frogfigther/Reach/README.md

# Reach
A repository containing the design files for the Reach board

Credit goes to Elias bakken for designing the basis of the reach, which we are now finishing 

(URL: http://bit.ly/2AH00zA)
