frogfigther/Reach/Reach_BOM_rev_B0.xls

Digikey Part nr. | Desc | Ref | QTY 1 | P. ea 1 | P. ext 1 | QTY 500 | P. ea 500 | P. ext 500
Connectors
A19450-ND | CONN HEADER RTANG 2POS .100 TIN | X4, X5, X6 | 3 | 0.1 | 0.3 | 1500 | 0.03768 | 56.52
A19451-ND | CONN HEADER RTANG 3POS .100 TIN | X7, X8, X9 | 3 | 0.14 | 0.42 | 1500 | 0.05733 | 85.995
A19452-ND | CONN HEADER RTANG 4POS .100 TIN | X14, X15, X16 | 3 | 0.18 | 0.54 | 1500 | 0.08734 | 131.01
WM7847-ND | CONN HEADER 4POS 5.08MM R/A TIN | X2 | 1 | 1.04 | 1.04 | 500 | 0.648 | 324
WM7953-ND | CONN TERM BLOCK 4POS 5.08MM R/A | X2-2, X20-2 | 1 | 2.5 | 2.5 | 500 | 1.5 | 750
WM7845-ND | CONN HEADER 2POS 5.08MM R/A TIN | X1, X3, X21 | 3 | 0.64 | 1.92 | 1500 | 0.4 | 600
WM7819-ND | CONN TERM BLOCK 2POS 5.08MM | X1-2, X3-2, X21-2 | 3 | 1.43 | 4.29 | 1500 | 0.88794 | 1331.91
S2012EC-23-ND | CONN HEADER .100" DUAL STR 46POS | P8, P9 | 2 | 0.72 | 1.44 | 1000 | 0.41646 | 416.46
ICs
296-28915-5-ND | IC CTRLR STEPPER MOTOR 28HTSSOP | U13, U14, U15 | 3 | 6.53 | 19.59 | 1500 | 3.2625 | 4893.75
CAT24C256WI-GT3OSCT-ND | IC EEPROM 256KBIT 400KHZ 8SOIC | U18 | 1 | 0.71 | 0.71 | 500 | 0.35536 | 177.68
MCP1402T-E/OTCT-ND | IC MOSFET DRIVER 500MA SOT23-5 | U7, U8, U9 | 3 | 0.74 | 2.22 | 1500 | 0.47 | 705
296-4620-1-ND | IC 8BIT SHFT REG TRI-ST 16-TSSOP | U1, U2, U3 | 3 | 0.49 | 1.47 | 1500 | 0.1326 | 198.9
1028-1045-1-ND | IC REG BUCK ADJ 2A 10MSOP | U10 | 1 | 0.76 | 0.76 | 500 | 0.38192 | 190.96
Resistors
RL12S.10FCT-ND | RES .10 OHM 1/3W 1% 0805 SMD | R1, R2, R3, R4, R5, R6 | 6 | 0.32 | 1.92 | 3000 | 0.06306 | 189.18
P100JCT-ND | RES 100 OHM 1/10W 5% 0402 SMD | R31, R32, R37 | 3 | 0.1 | 0.3 | 1500 | 0.0072 | 10.8
311-4.7KJRCT-ND | RES 4.7K OHM 1/16W 5% 0402 SMD | R7, R8, R9, R11, R12, R14, R15, R16, R19, R20, R21, R22, R23, R24, R35, R36, R45, R46, R47, R48, R55, R56, R57 | 23 | 0.012 | 0.276 | 11500 | 0.00336 | 38.64
P4.70KLCT-ND | RES 4.7K OHM 1/10W 1% 0402 SMD | R13, R17, R18 | 3 | 0.1 | 0.3 | 1500 | 0.01008 | 15.12
P6.8KJCT-ND | RES 6.8K OHM 1/10W 5% 0402 SMD | R38, R39, R40 | 3 | 0.1 | 0.3 | 1500 | 0.0072 | 10.8
P10KJCT-ND | RES 10K OHM 1/10W 5% 0402 SMD | R43 | 1 | 0.1 | 0.1 | 500 | 0.0072 | 3.6
RMCF0402FT40K2CT-ND | RES 40.2K OHM 1/16W 1% 0402 | R44 | 1 | 0.04 | 0.04 | 500 | 0.00576 | 2.88
RMCF0402FT120KCT-ND | RES 120K OHM 1/16W 1% 0402 | R42 | 1 | 0.04 | 0.04 | 500 | 0.00576 | 2.88
MOSFETs
AUIPS1051L-ND | IC SW IPS 1CH LOW SIDE SOT223 | Q4, Q5, Q6 | 3 | 1.28 | 3.84 | 1500 | 0.51294 | 769.41
785-1370-1-ND | MOSFET N-CH 30V 32A 8DFN | Q1, Q2, Q3 | 3 | 0.8 | 2.4 | 1500 | 0.4004 | 600.6
Capacitors
445-1256-1-ND | CAP CER 1000PF 50V 10% X7R 0402 | C56 | 1 | 0.1 | 0.1 | 500 | 0.0077 | 3.85
587-2237-1-ND | CAP CER 4700PF 50V 10% X7R 0402 | C57, C58, C59 | 3 | 0.08 | 0.24 | 1500 | 0.0096 | 14.4
311-1360-1-ND | CAP CER 10000PF 25V 10% X7R 0603 | C1, C3, C5, C54, C55 | 5 | 0.1 | 0.5 | 2500 | 0.00648 | 16.2
445-4964-1-ND | CAP CER 0.1UF 25V 10% X5R 0402 | C2, C4, C6, C13, C20, C22, C24, C27, C31, C33, C35, C38, C39, C40, C41, C42 | 16 | 0.04 | 0.64 | 8000 | 0.0102 | 81.6
445-4996-1-ND | CAP CER 0.47UF 6.3V 10% X5R 0402 | C14, C15, C16, C26, C45, C46 | 6 | 0.1 | 0.6 | 3000 | 0.0231 | 69.3
1276-1903-1-ND | CAP CER 4.7UF 25V 20% X5R 0603 | C30, C32, C34 | 3 | 0.3 | 0.9 | 1500 | 0.08188 | 122.82
445-11700-1-ND | CAP CER 10UF 25V 20% JB 1206 | C52 | 1 | 0.56 | 0.56 | 500 | 0.196 | 98
1276-2412-1-ND | CAP CER 22UF 6.3V 20% X5R 0805 | C53 | 1 | 0.27 | 0.27 | 500 | 0.066 | 33
PCE3917CT-ND | CAP ALUM 100UF 50V 20% SMD | C12 | 1 | 0.81 | 0.81 | 500 | 0.33496 | 167.48
Diodes/LEDs
475-2816-1-ND | LED CHIPLED BLUE 470NM 0603 SMD | LED1, LED2, LED3, LED4, LED5, LED6, LED7 | 7 | 0.21 | 1.47 | 3500 | 0.11178 | 391.23
475-3016-1-ND | LED POINTLED 628NM SUPER RED SMD | LED8, LED9, LED10, LED11 | 4 | 0.08 | 0.32
MBRA340T3GOSCT-ND | DIODE SCHOTTKY 40V 3A SMA | D1, D2, D3, D4 | 4 | 0.53 | 2.12 | 2000 | 0.24812 | 496.24
Inductors
587-2636-1-ND | INDUCTOR 33UH 1.7A 20% SMD | L2 | 1 | 0.57 | 0.57 | 500 | 0.37126 | 185.63
Other
F4991-ND | FUSE BLADE LP MINI 58V SILVR 20 | F1 | 1 | 0.96 | 0.96 | 500 | 0.495 | 247.5
3557K-ND | FUSE CLIP UNIVERSL AUTO BLADE PC | F1-1 | 2 | 0.21 | 0.42 | 1000 | 0.1148 | 114.8
CT2192MST-ND | SWITCH TAPE SEAL 2 POS SMD | S1 | 1 | 0.6 | 0.6 | 500 | 0.43302 | 216.51
Sum |  |  |  |  | 57.796 |  |  | 27.52931
