frogfigther/Reach/B0/Reach_B0_BOM v0.1.xlsx

Sheet: Reach_B0_BOM v0.1
Qty | Value | Description | Digikey | Qty 1 | Qty 10 | Qty 100 | Qty 500 | Qty 1000/5000 | Board Qty 1 |  | Board Qty 100 |  | Board Qty 500
6 | 22-05-7028-02 | CONNECTOR | A19450-ND | $0.10 | $0.81 | $5.01 | $20.73 | $82.04 | $0.60 |  | $24.88 |  | $15.03
3 | 22-05-7048-04 | CONNECTOR | A19452-ND | $0.16 | $1.54 | $9.50 | $39.30 | $68.78 | $0.48 |  | $28.50 |  | $14.25
9 | 74AHC1G126DCK | Single Bus Buffer Gate With 3-State Outputs | 296-8747-1-ND | $0.42 | $3.14 | $19.57 | $66.95 | $103.00 | $3.14 | Qty 10 | $120.51 |  | $88.06
2 | AON6752 |  | 785-1498-1-ND | $1.13 | $9.97 | $78.83 | $305.68 | $482.66 | $2.26 |  | $157.66 |  | $78.83
8 | BLM15HB121SN1 | EMIFIL (R) Chip Ferrite Bead for GHz Noise | 490-4000-1-ND | $0.19 | $1.45 | $9.33 | $35.25 | $60.13 | $1.45 | Qty 10 | $56.40 |  | $240.52
3 | 100uF |  | PCE4238CT-ND | $0.52 | $3.59 | $21.52 |  |  | $1.56 |  | $64.56 |  | $213.31 | PCE4238TR-ND Tape and Reel
34 | 0.1uF | CAPACITOR, European symbol | 445-12185-1-ND | $0.15 | $1.05 | $4.95 | $17.36 | $122.39 | $3.57 | Qty 10 Break | $118.05 |  | $416.13
2 | 10nF | CAPACITOR, European symbol | 445-12173-1-ND | $0.10 | $0.36 | $1.61 | $5.76 | $9.04 | $0.20 |  | $3.22 |  | $9.04
1 | 1nF | CAPACITOR, European symbol | 490-6315-1-ND | $0.10 | $0.26 | $1.18 | $4.22 |  | $0.10 |  | $1.18 |  | $4.22
3 | 22nF | CAPACITOR, European symbol | 490-8256-1-ND | $0.10 | $0.26 | $1.18 | $4.22 |  | $0.26 | Qty 10 | $3.54 |  | $12.66
14 | 4.7uF | CAPACITOR, European symbol | 490-5915-1-ND | $0.49 | $3.41 | $20.46 | $76.71 | $129.25 | $4.77 | Qty 10 Break | $214.79 |  | $180.95
6 | 10uF | CAPACITOR, European symbol | 587-3489-1-ND | $0.31 | $2.12 | $12.00 | $42.36 |  | $1.86 |  | $50.83 |  | $254.16
1 | CAT24C256 |  | CAT24C256WI-GT3OSCT-ND | $0.40 | $3.89 | $31.93 | $155.21 |  | $0.40 |  | $31.93 |  | $155.21
2 | F-2X23- |  | SAM1204-23-ND | $4.95 | $44.28 | $364.68 | $1441.36 | $2474.63 | $9.90 |  | $729.36 |  | $2474.63
1 | FUSE | Fuse | F4991-ND | $0.37 | $3.47 | $24.20 | $93.50 |  | $0.37 |  | $24.20 |  | $93.50
2 | FUSE | Fuse | 36-3557-ND | $0.21 | $1.97 | $13.68 | $57.86 | $94.68 | $0.42 |  | $27.36 |  | $94.68
8 | blue | LED | 475-2816-1-ND | $0.34 | $2.40 | $15.97 | $47.92 | $79.86 | $2.40 | Qty 10 | $76.67 |  | $319.44
1 |  | Header 2 | 277-1667-ND | $0.39 | $3.75 | $34.92 | $150.14 |  | $0.39 |  | $34.92 |  | $150.14
4 | MBRA340T3 | Surface Mount Schottky Power Rectifier | MBRA340T3GOSCT-ND | $0.47 | $4.02 | $29.98 | $117.78 | $182.03 | $1.88 |  | $117.78 | Qty 500 | $364.06
4 | MCP9600 |  | MCP9600-I/MX-ND | $5.04 |  | $382.13 |  |  | $20.16 |  | $1528.52 |  | $7642.60
2 | MSTBA2 | PHOENIX | 277-1106-ND | $0.60 | $5.75 | $53.48 | $229.91 | $416.50 | $1.20 |  | $106.96 |  | $416.50
1 | MSTBA4 | PHOENIX | 277-7452-ND | $1.30 | $12.63 | $108.56 | $477.90 |  | $1.30 |  | $108.56 |  | $477.90
3 | NEWPORT_THERMOCOUPLE_CONNECTORPCC-SMP-V | Newport Electronics miniature Thermocouple connector. | PCC-SMP-V-K | $2.20 |  |  |  | Newark Only | $6.60 |  | $660.00 |  | $3300.00
4 |  | NPN TRANSISTOR | MMBT2222ALT1GOSCT-ND | $0.11 | $1.01 | $5.52 | $16.99 | $23.17 | $0.44 |  | $16.99 | Qty 500 | $46.34
1 | PCA9685PW | 16-channel, 12-bit PWM Fm+ I2C-bus LED controller | 568-5931-1-ND | $2.43 | $21.84 | $175.51 | $721.00 |  | $2.43 |  | $175.51 |  | $721.00
13 | 10K | RESISTOR, European symbol | RMCF0402FT10K0CT-ND | $0.10 | $0.20 | $0.81 | $3.64 | $13.06 | $1.30 |  | $9.46 |  | $16.98
1 | 120K,1% | RESISTOR, European symbol | RMCF0402FT120KCT-ND | $0.10 | $0.20 | $0.81 | $3.64 |  | $0.10 |  | $0.81 |  | $3.64
3 | 2.2R | RESISTOR, European symbol | RMCF0402FT2R20CT-ND | $0.10 | $0.21 | $0.86 |  | $3.85 | $0.30 |  | $2.58 |  | $5.78
1 | 39K | RESISTOR, European symbol | RMCF0402FT39K0CT-ND | $0.10 | $0.20 | $0.81 |  | $3.64 | $0.10 |  | $0.81 |  | $3.64 | Qty 1000
2 | 4.3k | RESISTOR, European symbol | RMCF0402FT4K30CT-ND | $0.10 | $0.20 | $0.81 |  | $3.64 | $0.20 |  | $1.62 |  | $3.64
22 | 4.7K | RESISTOR, European symbol | RMCF0402FT4K70CT-ND | $0.10 | $0.20 | $0.81 |  | $13.06 | $0.44 | Qty 10 Break | $57.46 |  | $28.73
2 | 7.5k | RESISTOR, European symbol | RMCF0402FT7K50CT-ND | $0.10 | $0.20 | $0.81 |  | $3.64 | $0.20 | Qty 10 | $1.62 |  | $3.64
6 | 0.1R | RESISTOR, European symbol | RMCF0805JTR100CT-ND | $0.44 | $3.18 | $12.73 |  | $145.31 | $2.64 |  | $76.38 |  | $174.37
1 | 0 | Resistor | 311-0.0JRCT-ND | $0.10 | $0.10 | $0.38 | $1.15 |  | $0.10 |  | $0.38 |  | $1.15
8 | 100 | Resistor | RMCF0402FT100RCT-ND | $0.10 | $0.20 | $0.81 | $3.64 | $7.91 | $0.20 | Qty 10 | $3.64 | Qty 500 | $13.05 | Qty 5000
1 | 2.2k | Resistor | RMCF0402FT2K20CT-ND | $0.10 | $0.20 | $0.81 | $3.64 |  | $0.10 |  | $0.81 |  | $3.64
6 | 0 | Resistor | RMCF0805ZT0R00CT-ND | $0.10 | $0.16 | $0.65 | $1.98 | $2.92 | $0.16 | Qty 10 | $2.38 |  | $8.76
20 | 10k | Resistor | RMCF0805FT10K0CT-ND | $0.10 | $0.23 | $0.95 |  |  | $0.46 | Qty 10 Break | $19.00 |  | $26.50 | RMCF0805FT10K0TR-ND
1 | 33uH |  | 587-2636-1-ND | $0.62 | $5.43 | $38.81 | $163.01 |  | $0.62 |  | $38.81 |  | $163.01
1 | RT8268 |  | 1028-1045-1-ND | $0.74 | $6.49 | $50.06 | $185.40 |  | $0.74 |  | $50.06 |  | $185.40
3 | SN74AHC595PW | 8 bit shift registers with 3-state output registers | 296-4620-1-ND | $0.54 | $4.64 | $34.61 | $135.96 | $210.12 | $1.62 |  | $103.83 |  | $315.18
3 | TMC2130QFN36 |  | 1460-1130-1-ND | $5.33 | $47.58 | $390.16 | $1579.66 |  | $15.99 |  | $1170.48 |  | $4738.98
 |  |  |  |  |  |  |  | Totals | $93.41 |  | $6023.01 |  | $23479.25
 |  |  |  |  |  |  |  | Cost Per Board | $93.41 |  | $60.23 |  | $46.96

Sheet: Issues
C10, C12, C15, C19, C21, C31, C34, C37, C40, C77, C57, C59, C45, C46
Not available in an 0402 format. Smallest I can find is an 0603 format with ratings to match the other caps
