frogfigther/Reach/B0/i2c_addresses.xls

I2C address/capacitance table
For keeping track of used addresses and pullup resistor calculation
Replicape
Ref Des | IC | Address | Capacitance (pF)
U11 | PCA9685PW | 1111111X | 10
U18 | CAT24C256 | 1010100X | 8
Reach
U11 | PCA9685PW | 1011111X | 10
U18 | CAT24C256 | 1010101X | 8
U3 | MCP9600 | 1100000X | 5
U4 | MCP9600 | 1100001X | 5
U5 | MCP9600 | 1100010X | 5
U6 | MCP9600 | 1100011X | 5
 |  | Total: | 56
