frogfigther/Reach/B0/schematic.pdf

2 | 4 ³ ⁵ | + +- | - ABCDE | 1 | 2 | 3 | 4 | 5 | 6 | 7 | 8 | ABCDE 1 | 2 | 3 | 4 | 5 | 6 | 7 | 8

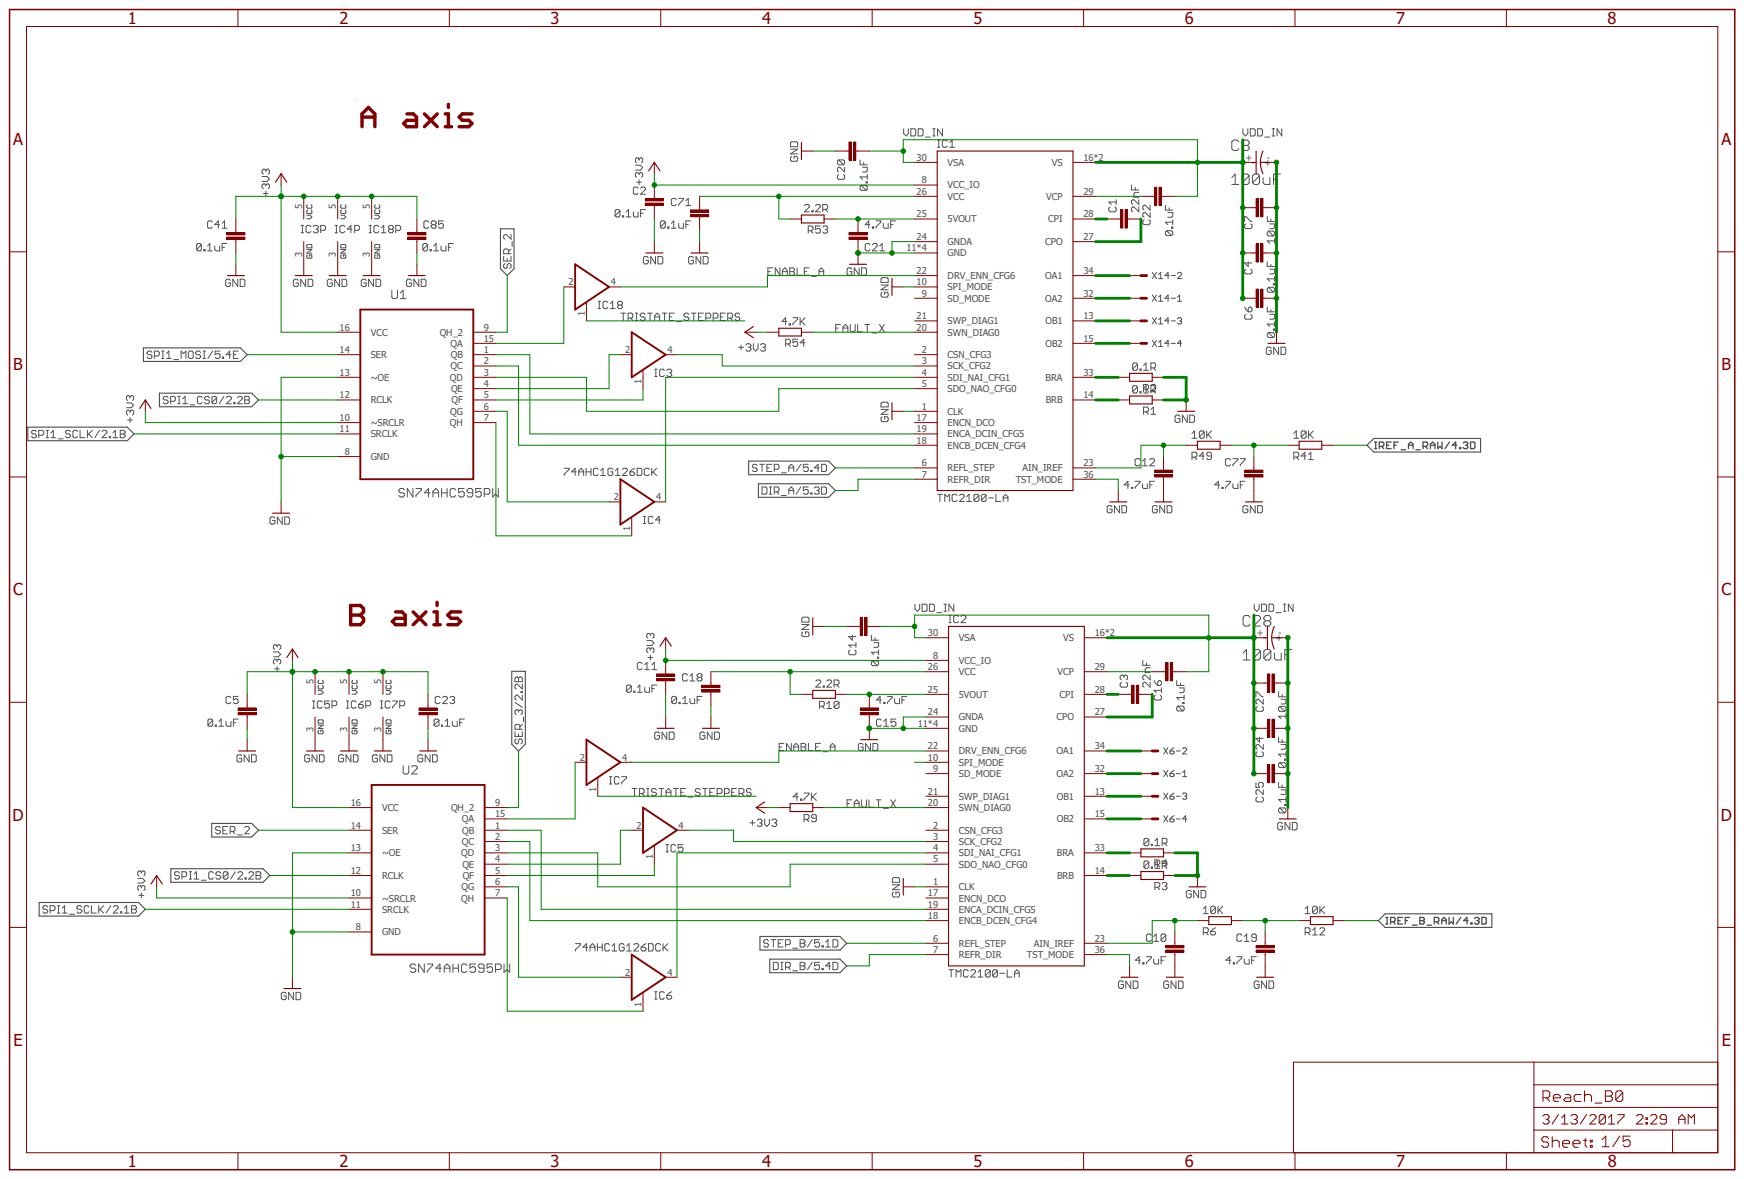
[picture p1: page 1]
VCC 16; SER 14; RCLK 12; ~SRCLR 10; SRCLK 11; GND 8; TST_MODE; CLK 1; CSN_CFG3 2; SCK_CFG2 3; SDI_NAI_CFG1 4; GND 11*4; SDO_NAO_CFG0 5; REFL_STEP 6 REFR_DIR 7; VCC_IO 8; SD_MODE 9; SPI_MODE 10; 13 BRB; ENCN_DCO 17; ENCB_DCEN_CFG4 18; ENCA_DCIN_CFG5 19; SWN_DIAG0 20; SWP_DIAG1 21; DRV_ENN_CFG6 22; AIN_IREF; GNDA 24; 5VOUT 25; VCC 26; CPO; CPI; VCP; VSA 30; 32 BRA

A

1 | 2 | 3 | 4 | 5 | 6 | 7 | 8

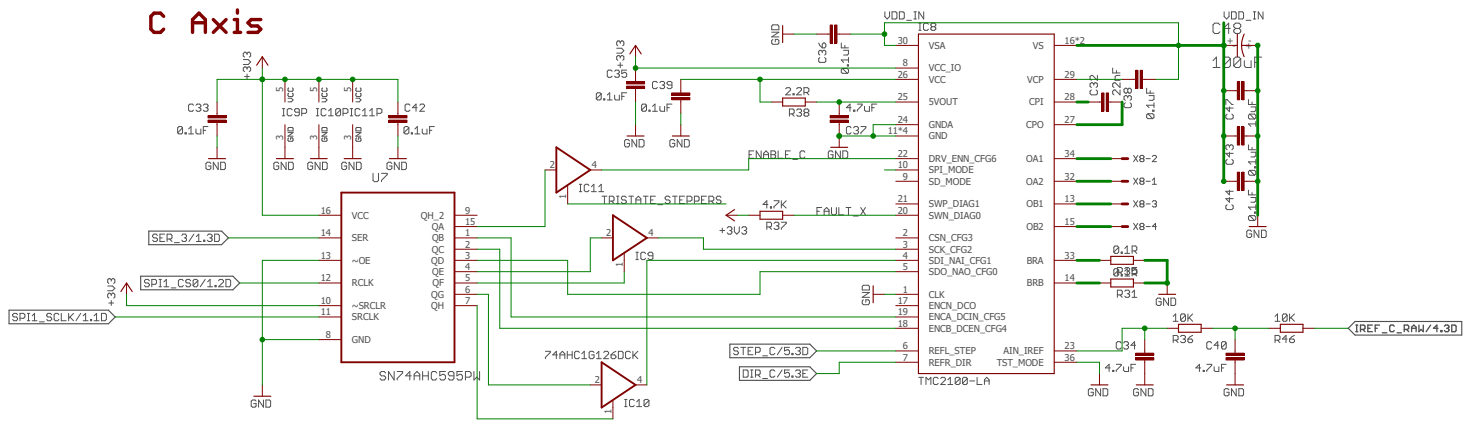
[picture p2: page 2]
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

A

A

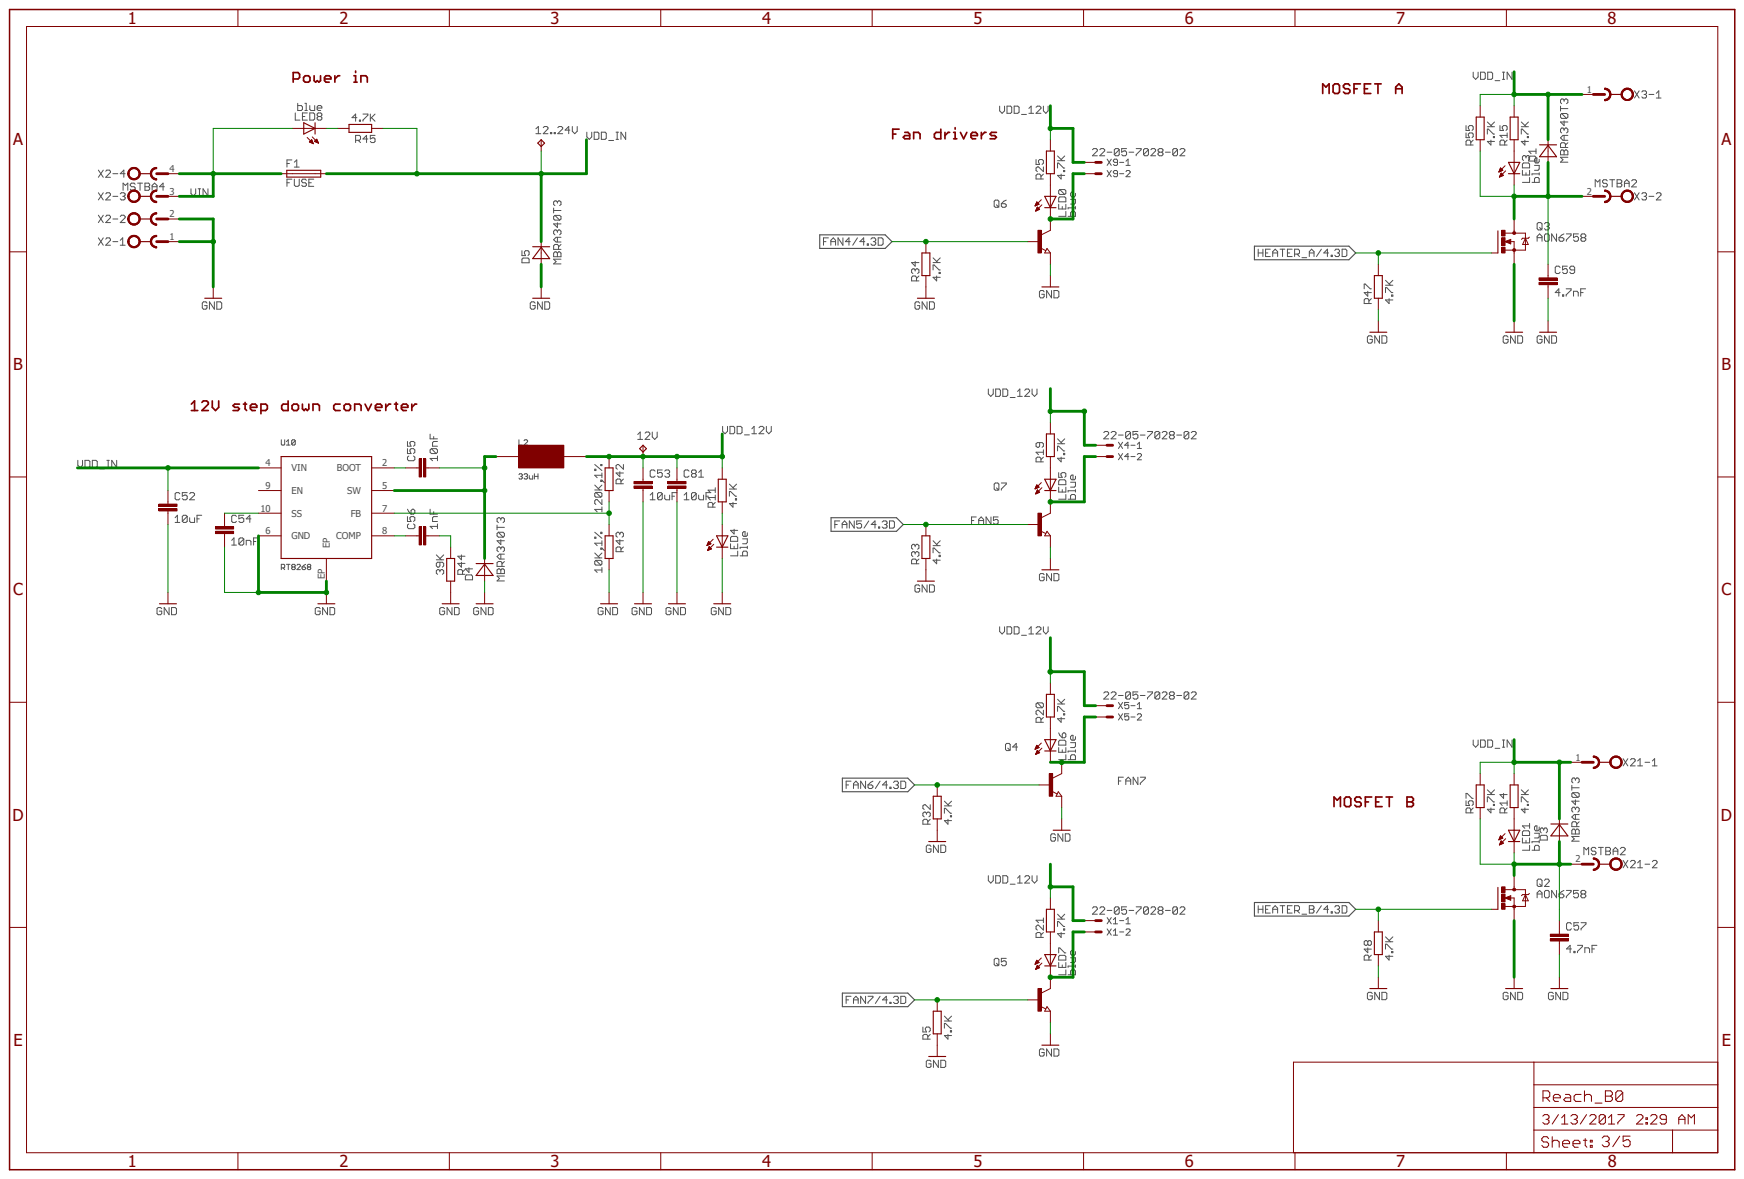
[picture p3: page 3]
BOOT; 7 COMP; 8 VIN 4; GND 6

SDA PAD ABCDE | 1 | 2 | 3 | 4 | 5 | 6 | 7 | 8 | ABCDE 1 | 2 | 3 | 4 | 5 | 6 | 7 | 8

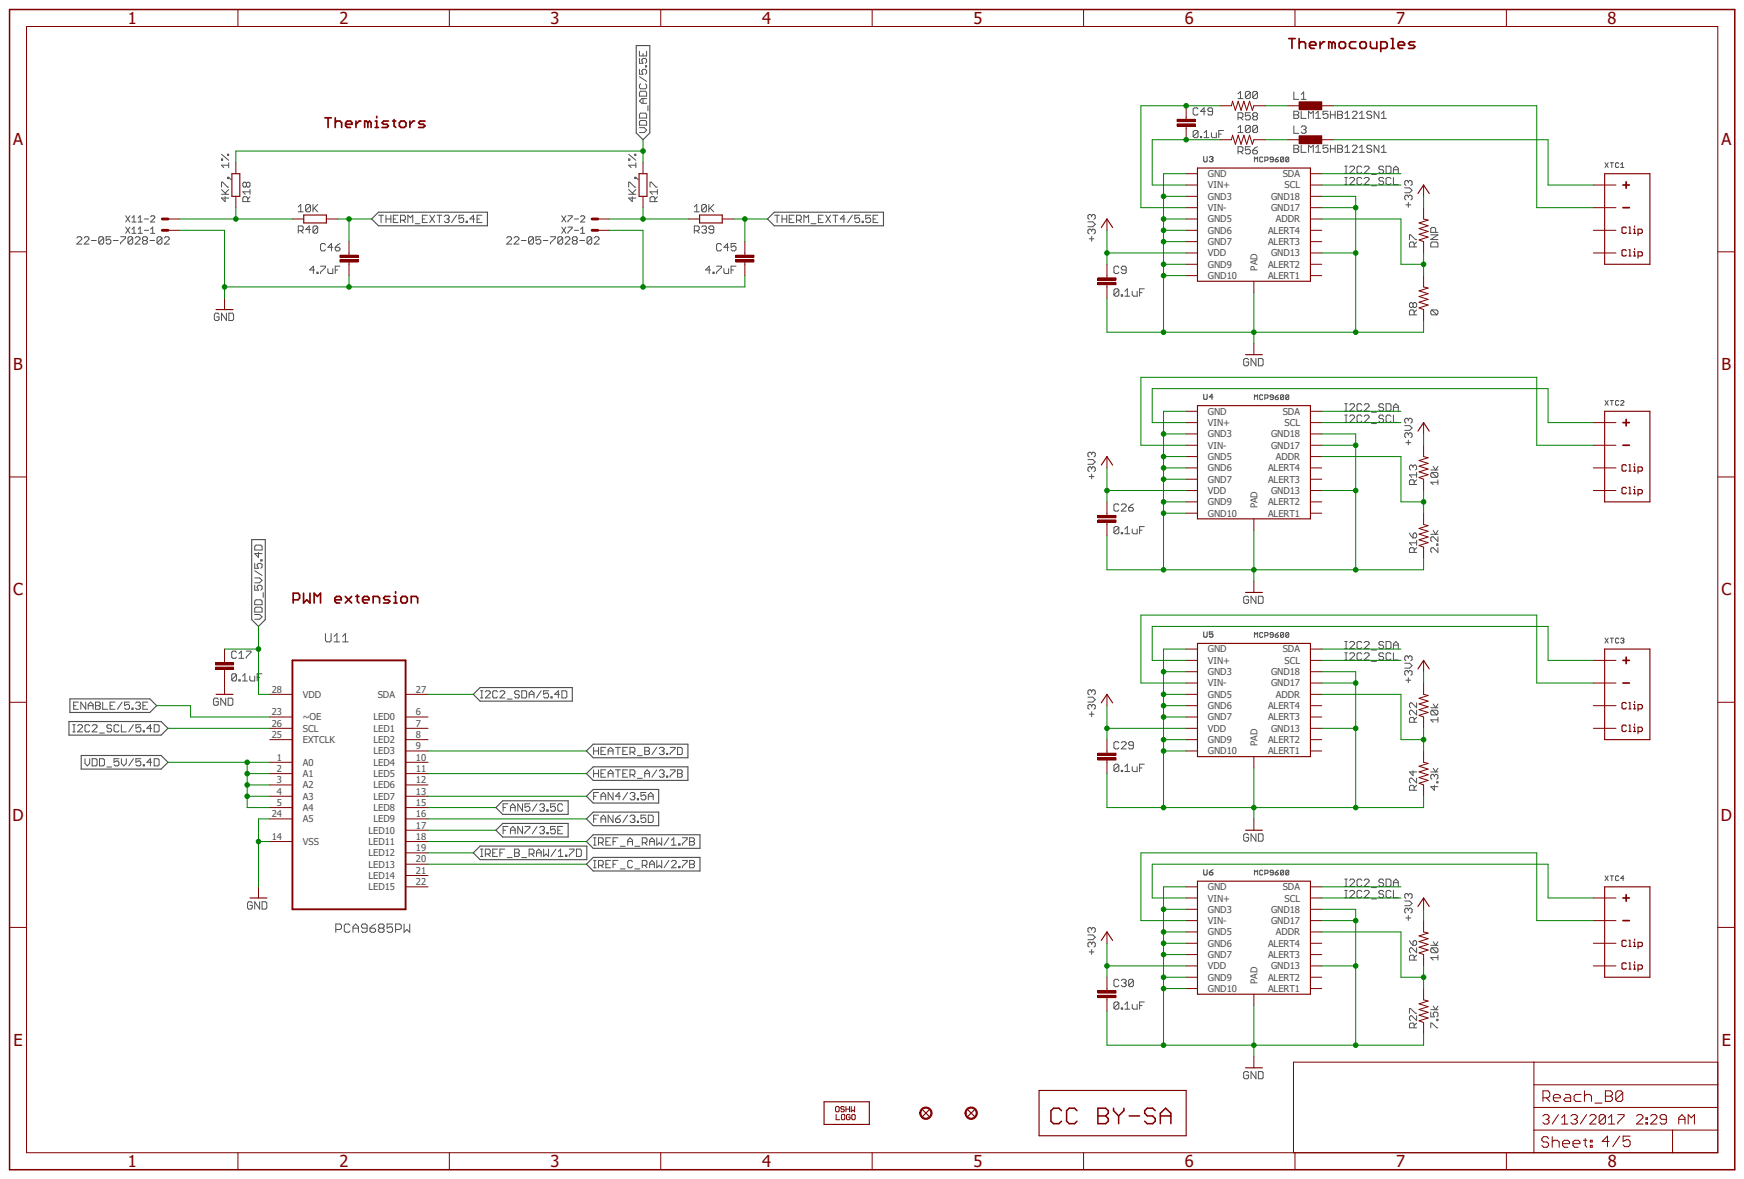
[picture p4: page 4]

45 | 46 ABCDE | 1 | 2 | 3 | 4 | 5 | 6 | 7 | 8 | ABCDE 1 | 2 | 3 | 4 | 5 | 6 | 7 | 8

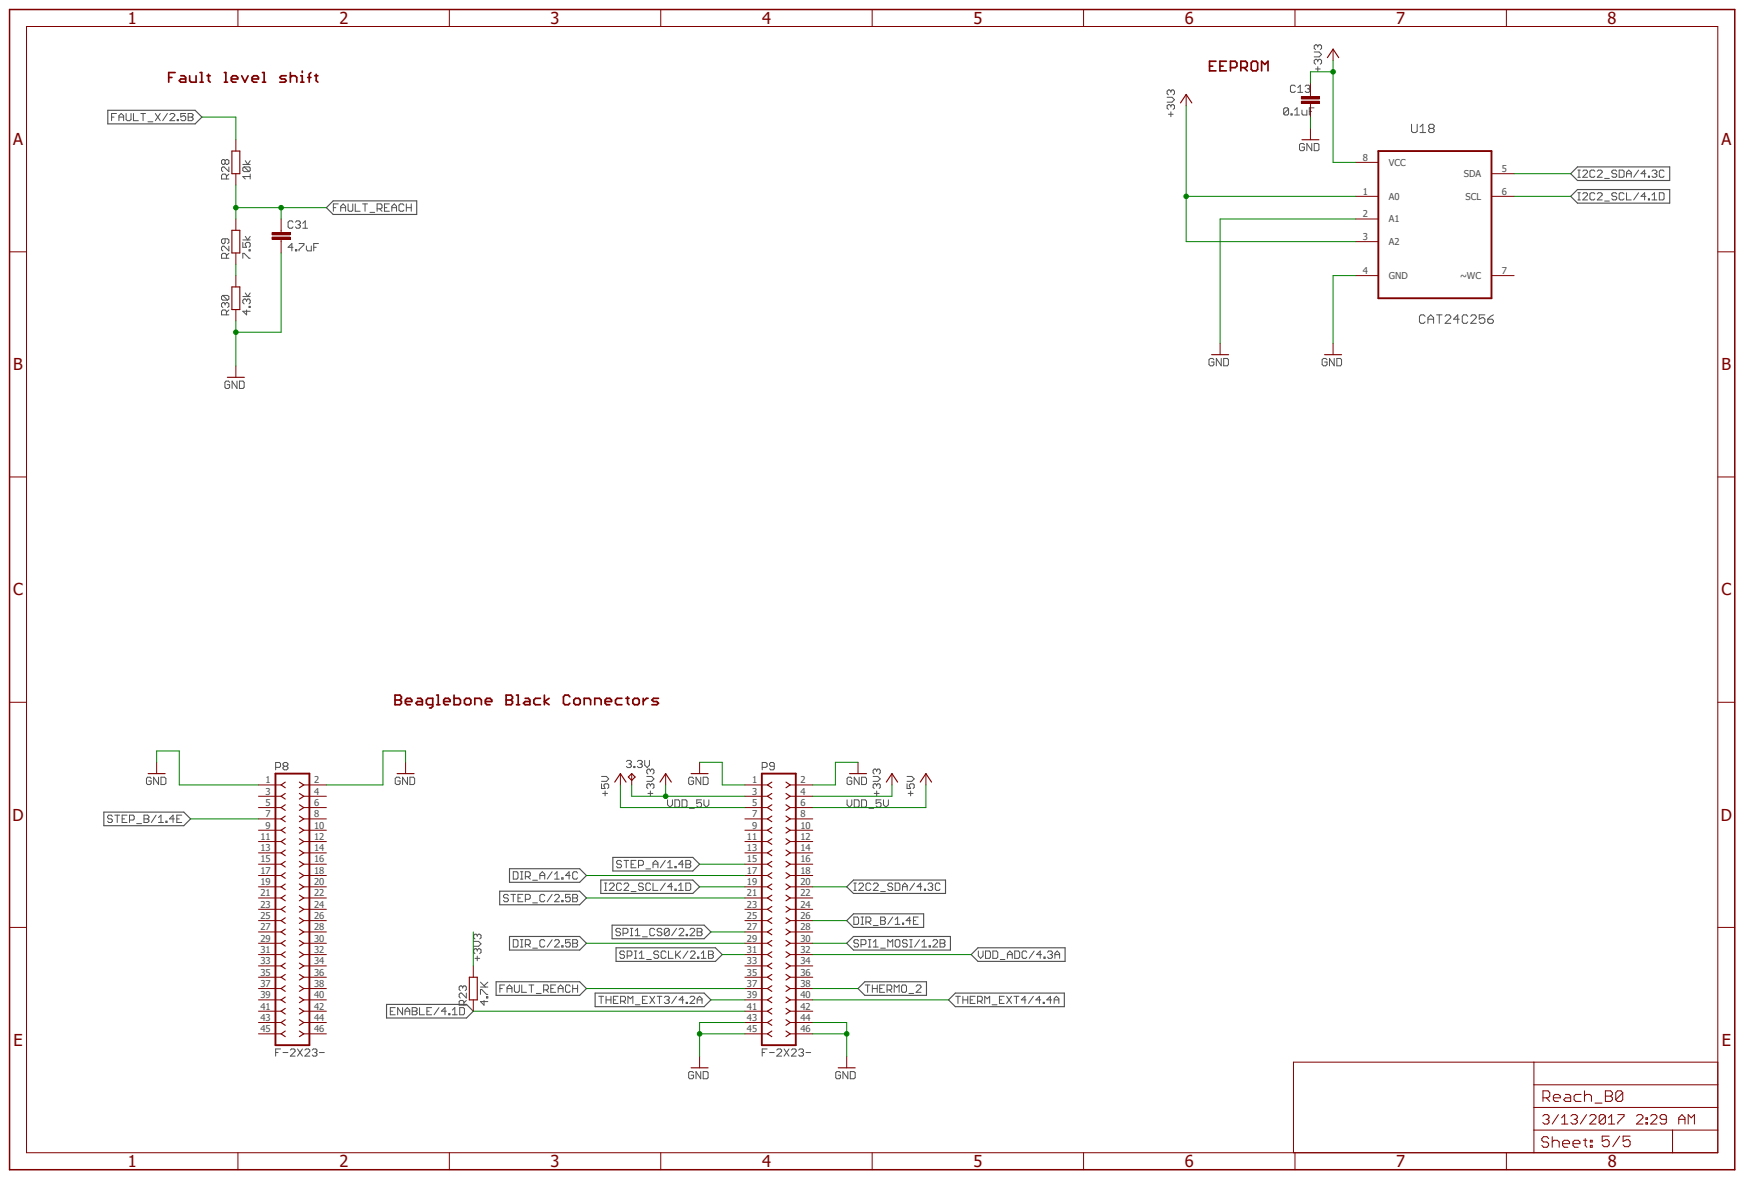
[picture p5: page 5]
VCC 8; 7 SCL; GND 4; SDA
