frogfigther/Reach/B0/Reach_B0.brd

## EAGLE design B0/Reach_B0.brd (2017-11-29)

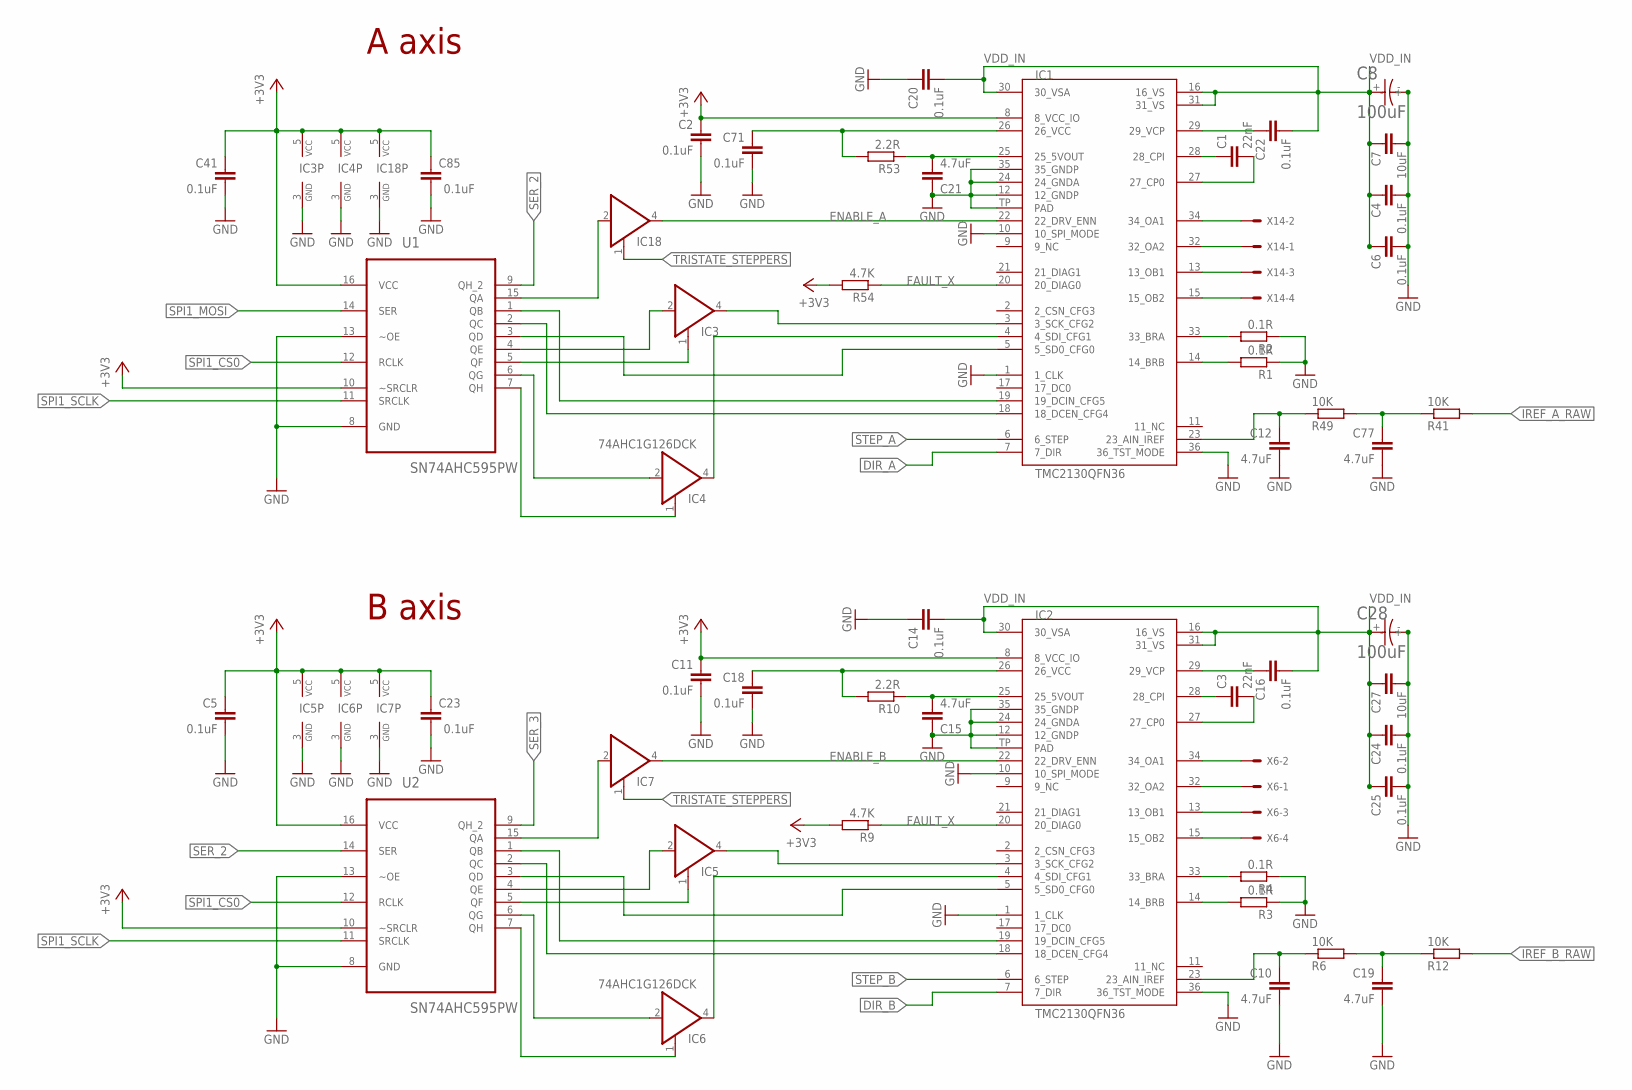
[picture p6: schematic Reach_B0.sch, sheet 1, A&B Stepper drivers]

Parts:
C1, C3: 22nF; C0402
C2, C5, C11, C14, C16, C18, C20, C22, C23, C41, C71, C85: 0.1uF; C0402
C4, C6, C24, C25: 0.1uF; C0402; MPN CL10B104KB8NNND
C7, C27: 10uF; C0805; MPN C2012X5R1V106M085AC
C8, C28: 100uF; RHS1V10MCN1GS; MPN RHS1V101MCN1GS
C10, C12, C15, C19, C21, C77: 4.7uF; C0402
IC1, IC2: TMC2130QFN36; QFN36
IC3, IC4, IC5, IC6, IC7, IC18: 74AHC1G126DCK; SC70-5
R1, R2, R3, R4: 0.1R; R0805
R6, R12, R41, R49: 10K; R0402
R9, R54: 4.7K; R0402
R10, R53: 2.2R; R0402
U1, U2: SN74AHC595PW; SOP65P640X120-16N
X6, X14: 22-05-7048-04; 7395-04

Connections:
+3V3: C2.1, C5.1, C11.1, C23.1, C41.1, C85.1, IC1.8 (8_VCC_IO), IC2.8 (8_VCC_IO), IC3.5 (VCC), IC4.5 (VCC), IC5.5 (VCC), IC6.5 (VCC), IC7.5 (VCC), IC18.5 (VCC), R9.2, R54.2, U1.10 (~SRCLR), U1.16 (VCC), U2.10 (~SRCLR), U2.16 (VCC); also elsewhere on the board
B_A3: IC2.34 (34_OA1), X6.2
B_A4: IC2.32 (32_OA2), X6.1
B_B3: IC2.15 (15_OB2), X6.4
B_B4: IC2.13 (13_OB1), X6.3
DIR_A: IC1.7 (7_DIR); also elsewhere on the board
DIR_B: IC2.7 (7_DIR); also elsewhere on the board
ENABLE_A: IC1.22 (22_DRV_ENN), IC18.4 (O)
ENABLE_B: IC2.22 (22_DRV_ENN), IC7.4 (O)
FAULT_X: IC1.20 (20_DIAG0), IC2.20 (20_DIAG0), R9.1, R54.1; also elsewhere on the board
GND: C2.2, C4.2, C5.2, C6.2, C7.2, C8.-, C10.2, C11.2, C12.2, C14.1, C15.1, C18.2, C19.2, C20.1, C21.1, C23.2, C24.2, C25.2, C27.2, C28.-, C41.2, C71.2, C77.2, C85.2, IC1.1 (1_CLK), IC1.10 (10_SPI_MODE), IC1.12 (12_GNDP), IC1.24 (24_GNDA), IC1.35 (35_GNDP), IC1.36 (36_TST_MODE), IC1.TP (PAD), IC2.1 (1_CLK), IC2.10 (10_SPI_MODE), IC2.12 (12_GNDP), IC2.24 (24_GNDA), IC2.35 (35_GNDP), IC2.36 (36_TST_MODE), IC2.TP (PAD), IC3.3 (GND), IC4.3 (GND), IC5.3 (GND), IC6.3 (GND), IC7.3 (GND), IC18.3 (GND), R1.1, R2.1, R3.1, R4.1, U1.8 (GND), U1.13 (~OE), U2.8 (GND), U2.13 (~OE); also elsewhere on the board
IREF_A: C77.1, R41.1, R49.2
IREF_A_RAW: R41.2; also elsewhere on the board
IREF_B: C19.1, R6.2, R12.1
IREF_B_RAW: R12.2; also elsewhere on the board
unnamed: C3.2, IC2.27 (27_CP0)
unnamed: IC2.14 (14_BRB), R3.2
unnamed: IC2.33 (33_BRA), R4.2
unnamed: IC4.1 (OE), U1.7 (QH)
unnamed: IC4.2 (I), U1.6 (QG)
unnamed: IC1.18 (18_DCEN_CFG4), U1.2 (QC)
unnamed: C1.1, IC1.28 (28_CPI)
unnamed: C1.2, IC1.27 (27_CP0)
unnamed: IC1.14 (14_BRB), R1.2
unnamed: IC1.33 (33_BRA), R2.2
unnamed: C12.1, IC1.23 (23_AIN_IREF), R49.1
unnamed: C10.1, IC2.23 (23_AIN_IREF), R6.1
unnamed: C3.1, IC2.28 (28_CPI)
unnamed: C15.2, IC2.25 (25_5VOUT), R10.1
unnamed: C16.1, IC2.29 (29_VCP)
unnamed: IC2.18 (18_DCEN_CFG4), U2.2 (QC)
unnamed: IC2.19 (19_DCIN_CFG5), U2.1 (QB)
unnamed: IC6.1 (OE), U2.7 (QH)
unnamed: IC6.2 (I), U2.6 (QG)
unnamed: IC5.2 (I), U2.4 (QE)
unnamed: C21.2, IC1.25 (25_5VOUT), R53.1
unnamed: IC5.1 (OE), U2.5 (QF)
unnamed: C22.1, IC1.29 (29_VCP)
unnamed: IC3.2 (I), U1.4 (QE)
unnamed: IC2.5 (5_SD0_CFG0), U2.3 (QD)
unnamed: C18.1, IC2.26 (26_VCC), R10.2
unnamed: IC7.2 (I), U2.15 (QA)
unnamed: IC3.1 (OE), U1.5 (QF)
unnamed: IC1.19 (19_DCIN_CFG5), U1.1 (QB)
unnamed: IC1.5 (5_SD0_CFG0), U1.3 (QD)
unnamed: C71.1, IC1.26 (26_VCC), R53.2
unnamed: IC18.2 (I), U1.15 (QA)
SER_2: U1.9 (QH_2), U2.14 (SER)
SER_3: U2.9 (QH_2); also elsewhere on the board
SPI1_CS0: U1.12 (RCLK), U2.12 (RCLK); also elsewhere on the board
SPI1_MOSI: U1.14 (SER); also elsewhere on the board
SPI1_SCLK: U1.11 (SRCLK), U2.11 (SRCLK); also elsewhere on the board
STEP_A: IC1.6 (6_STEP); also elsewhere on the board
STEP_B: IC2.6 (6_STEP); also elsewhere on the board
TRISTATE_STEPPERS: IC7.1 (OE), IC18.1 (OE); also elsewhere on the board
VDD_IN: C4.1, C6.1, C7.1, C8.+, C14.2, C16.2, C20.2, C22.2, C24.1, C25.1, C27.1, C28.+, IC1.16 (16_VS), IC1.30 (30_VSA), IC1.31 (31_VS), IC2.16 (16_VS), IC2.30 (30_VSA), IC2.31 (31_VS); also elsewhere on the board
X_A1: IC1.34 (34_OA1), X14.2
X_A2: IC1.32 (32_OA2), X14.1
X_B1: IC1.13 (13_OB1), X14.3
X_B2: IC1.15 (15_OB2), X14.4
X_CFG1: IC1.4 (4_SDI_CFG1), IC4.4 (O)
X_CFG2: IC1.3 (3_SCK_CFG2), IC3.4 (O)
X_CFG3: IC2.3 (3_SCK_CFG2), IC5.4 (O)
X_CFG4: IC2.4 (4_SDI_CFG1), IC6.4 (O)

Notes on the sheet:
A axis
B axis

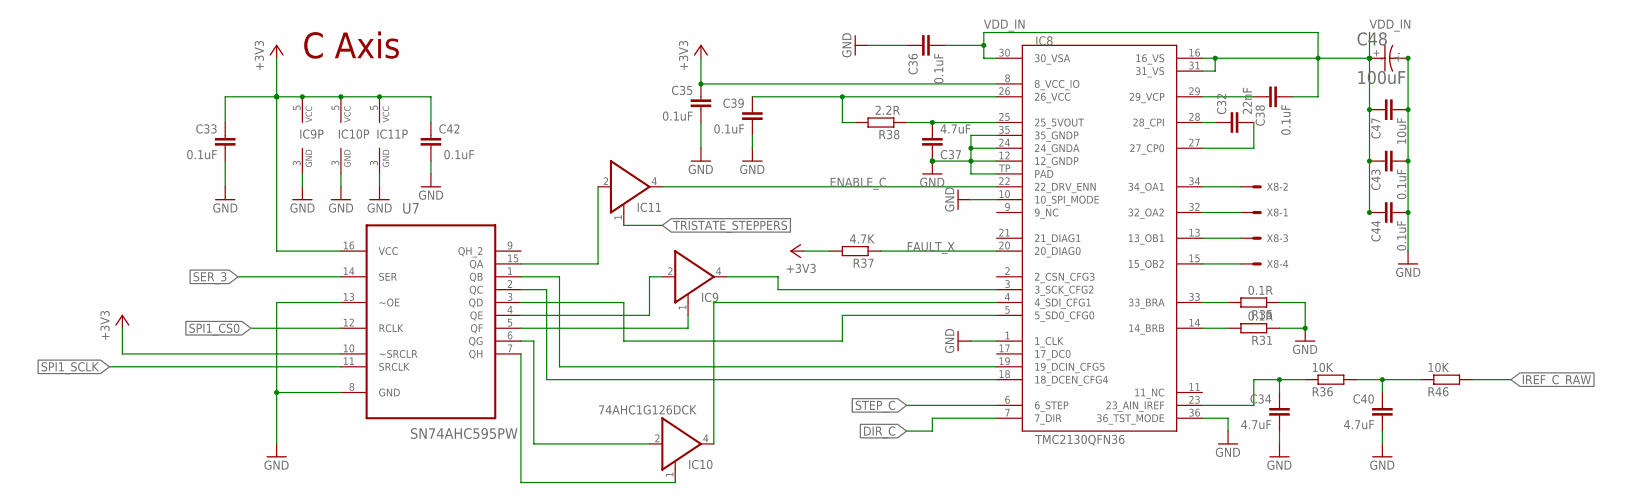
[picture p7: schematic Reach_B0.sch, sheet 2, C Stepper driver]

Parts:
C32: 22nF; C0402
C33, C35, C36, C38, C39, C42: 0.1uF; C0402
C34, C37, C40: 4.7uF; C0402
C43, C44: 0.1uF; C0402; MPN CL10B104KB8NNND
C47: 10uF; C0805; MPN C2012X5R1V106M085AC
C48: 100uF; RHS1V10MCN1GS; MPN RHS1V101MCN1GS
IC8: TMC2130QFN36; QFN36
IC9, IC10, IC11: 74AHC1G126DCK; SC70-5
R31, R35: 0.1R; R0805
R36, R46: 10K; R0402
R37: 4.7K; R0402
R38: 2.2R; R0402
U7: SN74AHC595PW; SOP65P640X120-16N
X8: 22-05-7048-04; 7395-04

Connections:
+3V3: C33.1, C35.1, C42.1, IC8.8 (8_VCC_IO), IC9.5 (VCC), IC10.5 (VCC), IC11.5 (VCC), R37.2, U7.10 (~SRCLR), U7.16 (VCC); also elsewhere on the board
C_A3: IC8.34 (34_OA1), X8.2
C_A4: IC8.32 (32_OA2), X8.1
C_B3: IC8.15 (15_OB2), X8.4
C_B4: IC8.13 (13_OB1), X8.3
DIR_C: IC8.7 (7_DIR); also elsewhere on the board
ENABLE_C: IC8.22 (22_DRV_ENN), IC11.4 (O)
FAULT_X: IC8.20 (20_DIAG0), R37.1; also elsewhere on the board
GND: C33.2, C34.2, C35.2, C36.1, C37.1, C39.2, C40.2, C42.2, C43.2, C44.2, C47.2, C48.-, IC8.1 (1_CLK), IC8.10 (10_SPI_MODE), IC8.12 (12_GNDP), IC8.24 (24_GNDA), IC8.35 (35_GNDP), IC8.36 (36_TST_MODE), IC8.TP (PAD), IC9.3 (GND), IC10.3 (GND), IC11.3 (GND), R31.1, R35.1, U7.8 (GND), U7.13 (~OE); also elsewhere on the board
IREF_C: C40.1, R36.2, R46.1
IREF_C_RAW: R46.2; also elsewhere on the board
unnamed: C32.2, IC8.27 (27_CP0)
unnamed: IC8.14 (14_BRB), R31.2
unnamed: IC8.33 (33_BRA), R35.2
unnamed: C34.1, IC8.23 (23_AIN_IREF), R36.1
unnamed: C32.1, IC8.28 (28_CPI)
unnamed: C37.2, IC8.25 (25_5VOUT), R38.1
unnamed: C38.1, IC8.29 (29_VCP)
unnamed: IC8.18 (18_DCEN_CFG4), U7.2 (QC)
unnamed: IC8.19 (19_DCIN_CFG5), U7.1 (QB)
unnamed: IC10.1 (OE), U7.7 (QH)
unnamed: IC10.2 (I), U7.6 (QG)
unnamed: IC9.2 (I), U7.4 (QE)
unnamed: IC9.1 (OE), U7.5 (QF)
unnamed: IC8.5 (5_SD0_CFG0), U7.3 (QD)
unnamed: C39.1, IC8.26 (26_VCC), R38.2
unnamed: IC11.2 (I), U7.15 (QA)
SER_3: U7.14 (SER); also elsewhere on the board
SPI1_CS0: U7.12 (RCLK); also elsewhere on the board
SPI1_SCLK: U7.11 (SRCLK); also elsewhere on the board
STEP_C: IC8.6 (6_STEP); also elsewhere on the board
TRISTATE_STEPPERS: IC11.1 (OE); also elsewhere on the board
VDD_IN: C36.2, C38.2, C43.1, C44.1, C47.1, C48.+, IC8.16 (16_VS), IC8.30 (30_VSA), IC8.31 (31_VS); also elsewhere on the board
X_CFG5: IC8.3 (3_SCK_CFG2), IC9.4 (O)
X_CFG6: IC8.4 (4_SDI_CFG1), IC10.4 (O)

Notes on the sheet:
C Axis

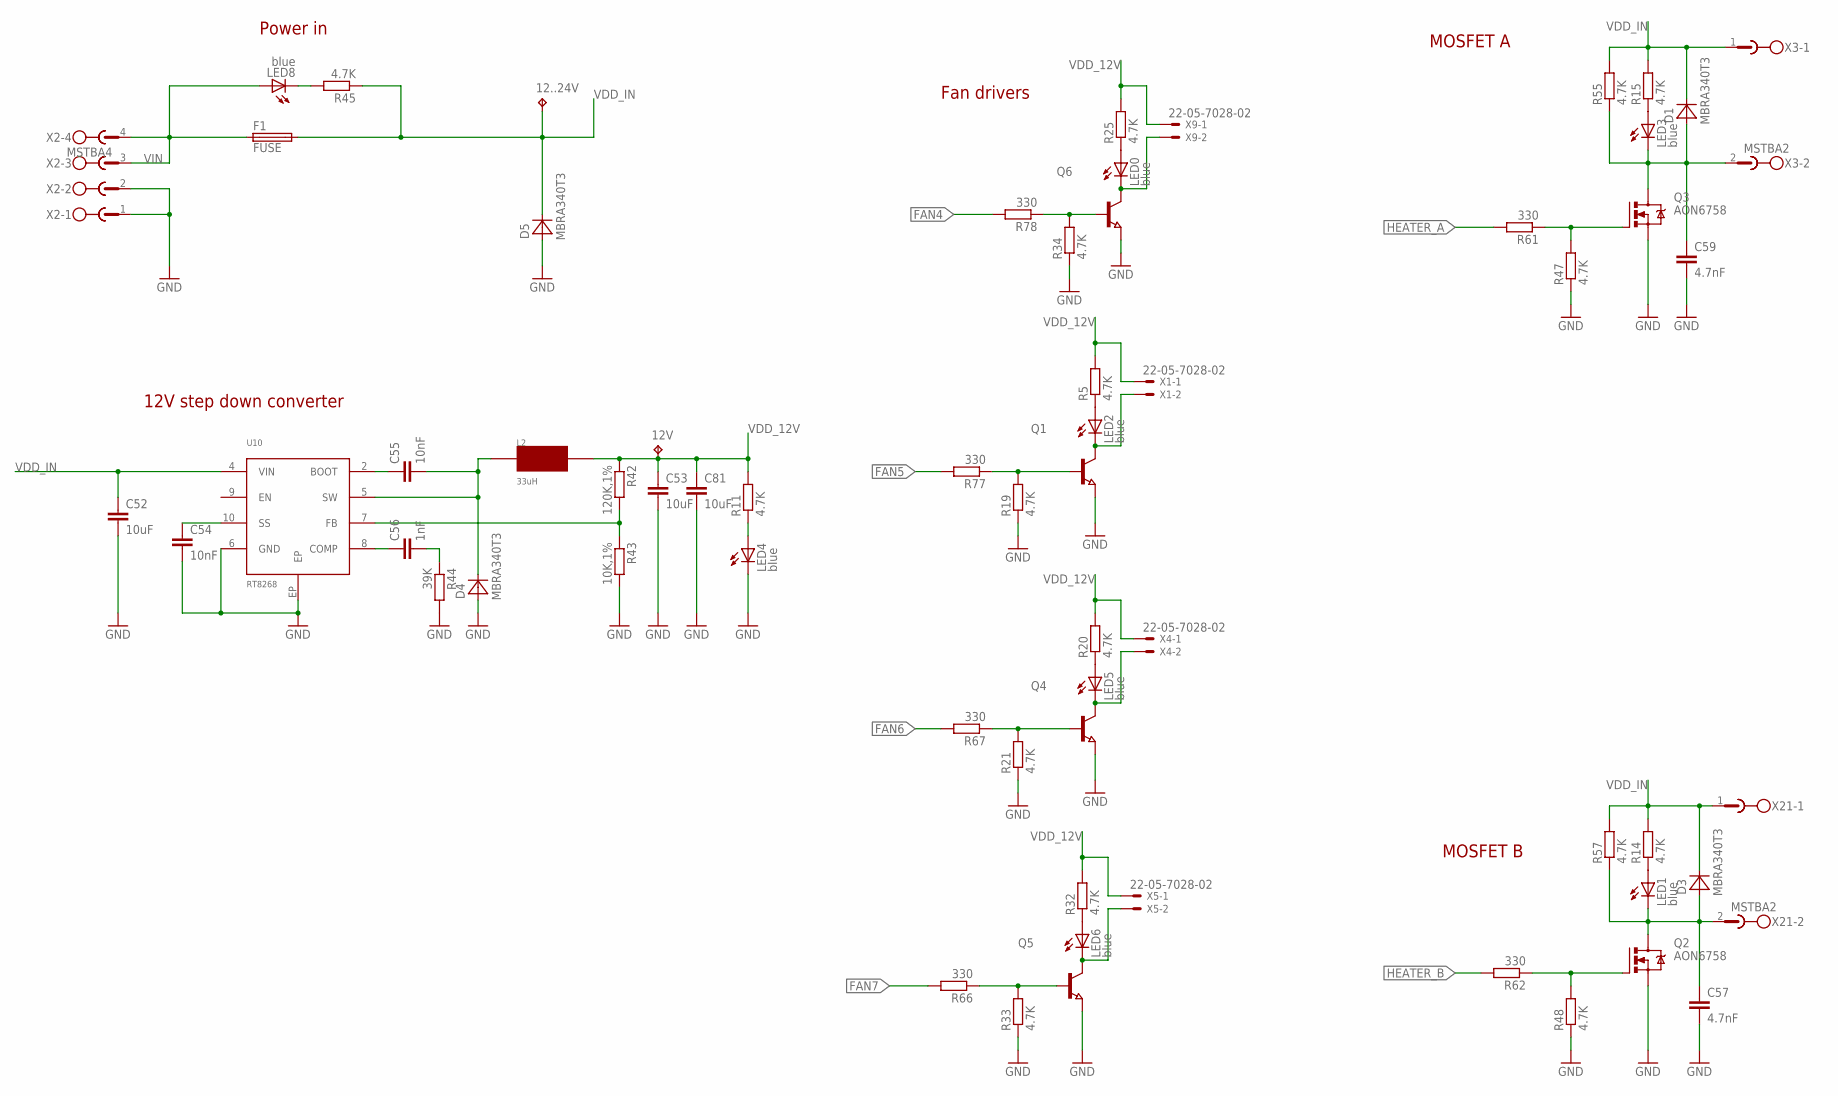
[picture p8: schematic Reach_B0.sch, sheet 3, Supply and power electronics]

Parts:
12..24V, 12V: TPB1,27; B1,27
C52, C53, C81: 10uF; C1206; MPN CL31B106KAHNNNE
C54, C55: 10nF; C0402; MPN CL05B103KB5NNNC
C56: 1nF; C0402; MPN C1005X7R1H102K050BA
C57, C59: 4.7nF; C0402
D1, D3, D5: MBRA340T3; SMA
D4: MBRA340T3; SMA; MPN MBRA340T3G
F1: FUSE; 3557
L2: 33uH; NR8040T330; MPN NR8040T330M
LED0, LED2, LED4, LED5, LED6: blue; CHIP-LED0603; MPN Q65110A7211
LED1, LED3, LED8: blue; CHIP-LED0603
Q1, Q4, Q5, Q6: NPN-TRANSISTOR_SOT23; SOT23; MPN AO7400
Q2, Q3: AON6758; 8-DFN-EP-(5X6)
R5, R11, R19, R20, R21, R25, R32, R33, R34: 4.7K; R0402; MPN RC0402JR-074K7L
R14, R15, R45, R47, R48, R55, R57: 4.7K; R0402
R42: 120K,1%; R0402; MPN RMCF0402FT120K
R43: 10K,1%; R0402; MPN RC0402FR-0710KL
R44: 39K; R0402; MPN RC1005J393CS
R61, R62, R66, R67, R77, R78: 330; R0402
U10: RT8268; MSOP10; MPN RT8268GFP
X1, X4, X5, X9: 22-05-7028-02; 7395-02; MPN 640455-2
X2: MSTBA4
X3, X21: MSTBA2

Connections:
FAN4: R78.2; also elsewhere on the board
FAN5: R77.2; also elsewhere on the board
FAN6: R67.2; also elsewhere on the board
FAN7: R66.2; also elsewhere on the board
GND: C52.2, C53.2, C54.2, C57.2, C59.2, C81.2, D4.A, D5.A, LED4.C, Q1.2 (E), Q2.1 (S), Q2.2 (S), Q2.3 (S), Q3.1 (S), Q3.2 (S), Q3.3 (S), Q4.2 (E), Q5.2 (E), Q6.2 (E), R19.1, R21.1, R33.1, R34.1, R43.2, R44.2, R47.1, R48.1, U10.6 (GND), U10.EP, X2.1, X2.2; also elsewhere on the board
HEATER_A: R61.2; also elsewhere on the board
HEATER_B: R62.2; also elsewhere on the board
unnamed: LED8.C, R45.2
unnamed: LED2.C, Q1.3 (C), X1.2
unnamed: LED0.C, Q6.3 (C), X9.2
unnamed: LED0.A, R25.1
unnamed: Q3.4 (G), R47.2, R61.1
unnamed: C57.1, D3.A, LED1.C, Q2.5 (D), Q2.6 (D), Q2.7 (D), Q2.8 (D), Q2.TH (D), R57.1, X21.2
unnamed: Q2.4 (G), R48.2, R62.1
unnamed: Q5.1 (B), R33.2, R66.1
unnamed: Q4.1 (B), R21.2, R67.1
unnamed: LED2.A, R5.1
unnamed: LED5.C, Q4.3 (C), X4.2
unnamed: LED5.A, R20.1
unnamed: LED6.C, Q5.3 (C), X5.2
unnamed: LED6.A, R32.1
unnamed: Q1.1 (B), R19.2, R77.1
unnamed: Q6.1 (B), R34.2, R78.1
unnamed: LED4.A, R11.1
unnamed: LED3.A, R15.1
unnamed: LED1.A, R14.1
unnamed: R42.2, R43.1, U10.7 (FB)
unnamed: C59.1, D1.A, LED3.C, Q3.5 (D), Q3.6 (D), Q3.7 (D), Q3.8 (D), Q3.TH (D), R55.1, X3.2
unnamed: C55.2, D4.C, L2.P$2, U10.5 (SW)
unnamed: C54.1, U10.10 (SS)
unnamed: C56.1, U10.8 (COMP)
unnamed: C55.1, U10.2 (BOOT)
unnamed: C56.2, R44.1
VDD_12V: 12V.TP, C53.1, C81.1, L2.P$1, R5.2, R11.2, R20.2, R25.2, R32.2, R42.1, X1.1, X4.1, X5.1, X9.1
VDD_IN: 12..24V.TP, C52.1, D1.C, D3.C, D5.C, F1.P$3 (2), F1.P$4 (2), R14.2, R15.2, R45.1, R55.2, R57.2, U10.4 (VIN), X3.1, X21.1; also elsewhere on the board
VIN: F1.P$1 (1), F1.P$2 (1), LED8.A, X2.3, X2.4

Notes on the sheet:
Power in
MOSFET A
MOSFET B
12V step down converter
Fan drivers

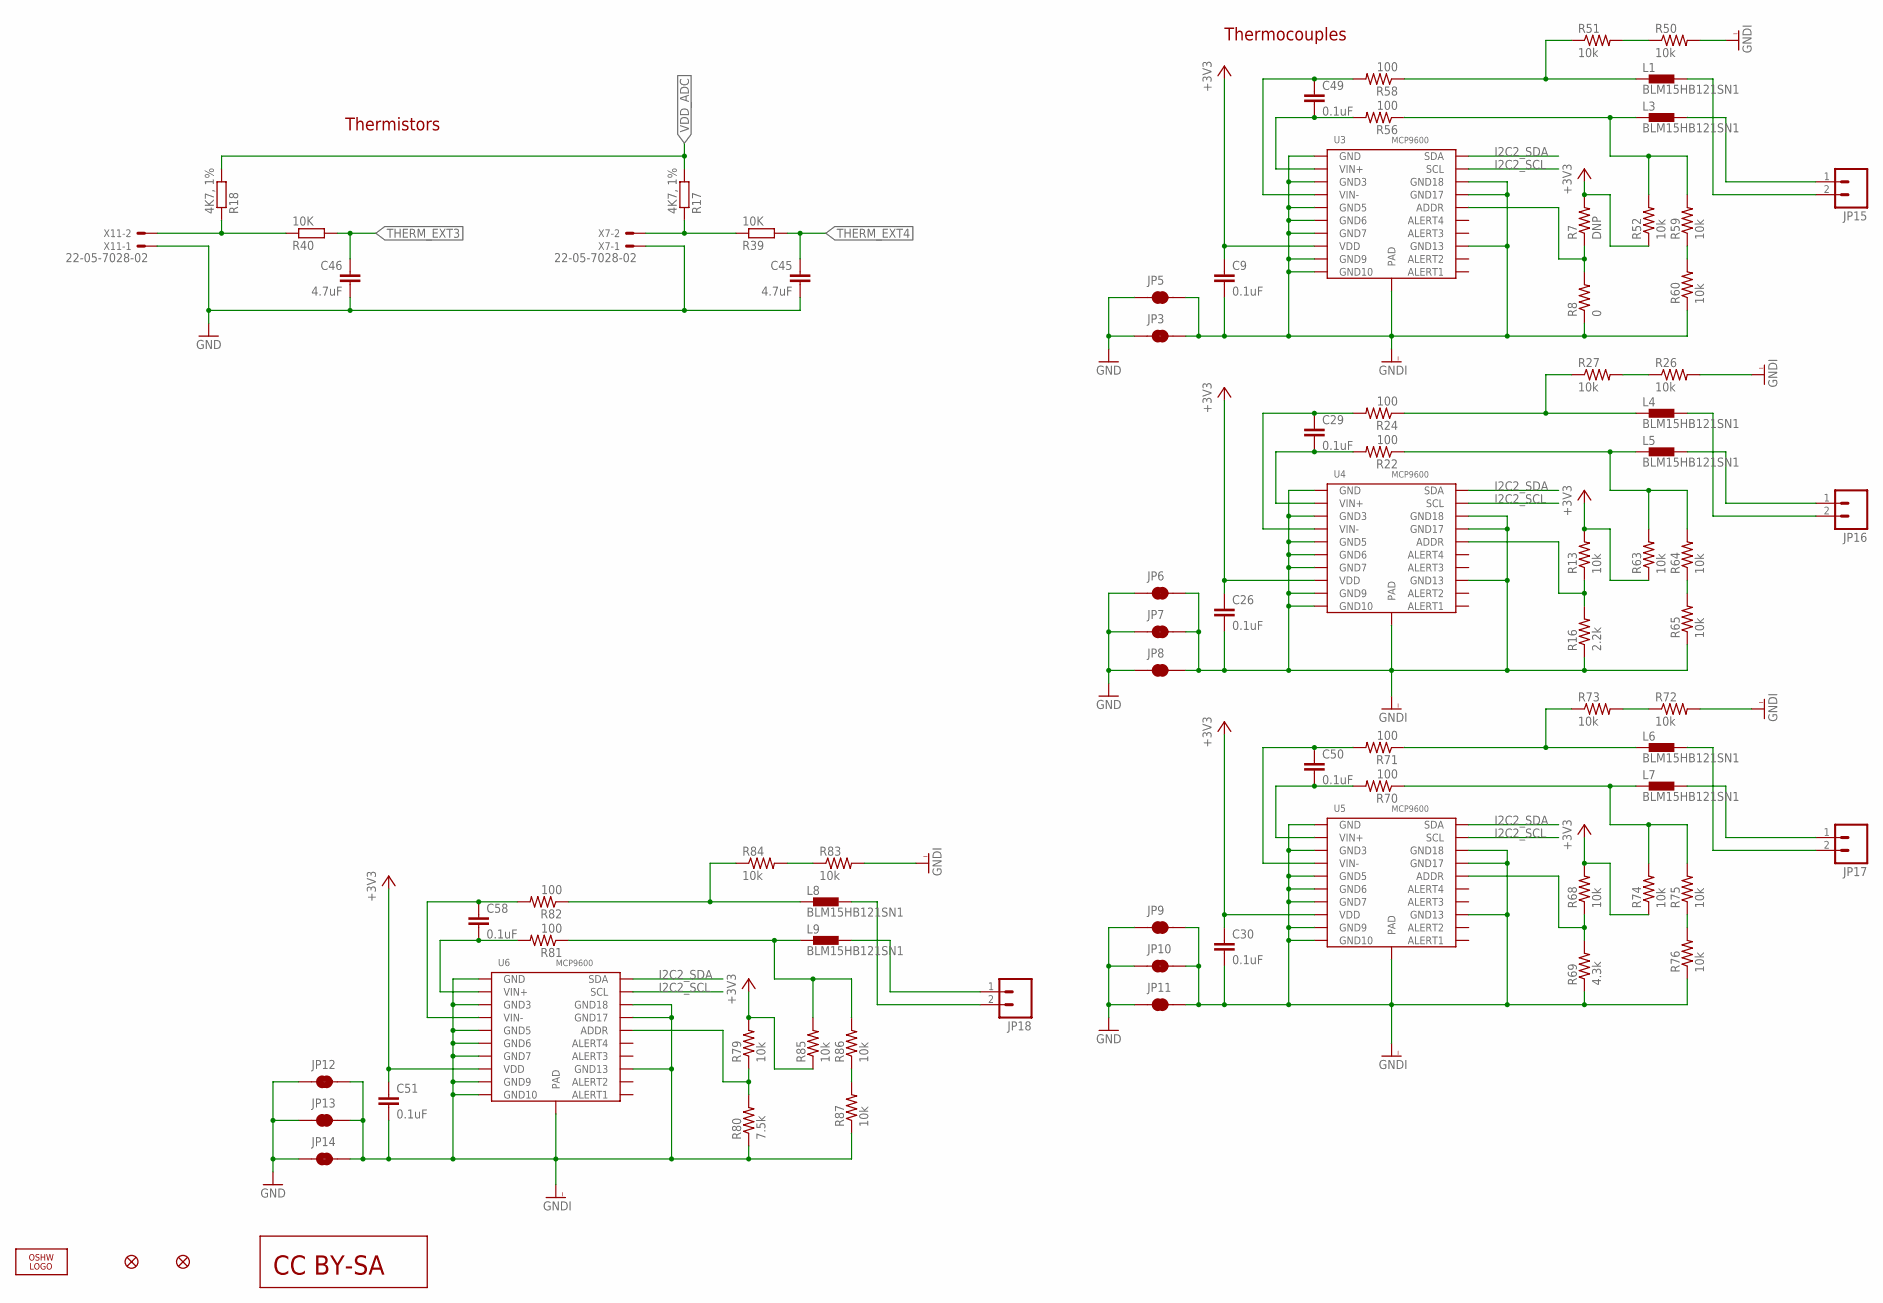
[picture p9: schematic Reach_B0.sch, sheet 4, Sensors (temp)]

Parts:
C9, C26, C29, C30, C49, C50, C51, C58: 0.1uF; C0402
C45, C46: 4.7uF; C0402; MPN GRM155R60J475ME47D
JP1, JP2: FIDUCIAL1X2.5; FIDUCIAL-1X2.5
JP3, JP5, JP6, JP7, JP8, JP9, JP10, JP11, JP12, JP13, JP14: JUMPER-PAD-2-NC_BY_TRACE; PAD-JUMPER-2-NC_BY_TRACE_YES_SILK
JP15, JP16, JP17, JP18: M025MM; SCREWTERMINAL-5MM-2
L1, L3, L4, L5, L6, L7, L8, L9: BLM15HB121SN1; 0402
LOGO1: OSHW_LOGO_FILLX0200-NT; OSHW_FILLX200_NOTEXT
R7: DNP; 0402-RES
R8: 0; 0402-RES
R13, R68, R79: 10k; 0402-RES
R16: 2.2k; 0402-RES
R17, R18: 4K7, 1%; R0402; MPN RC0402FR-074K7L
R22, R24, R56, R58, R70, R71, R81, R82: 100; 0402-RES
R26, R27, R50, R51, R52, R59, R60, R63, R64, R65, R72, R73, R74, R75, R76, R83, R84, R85, R86, R87: 10k; 0805
R39, R40: 10K; R0402; MPN RC0402FR-0710KL
R69: 4.3k; 0402-RES
R80: 7.5k; 0402-RES
U3, U4, U5, U6: MCP9600; MQFN-20
U$4: CC-BY-SA
X7, X11: 22-05-7028-02; 7395-02; MPN 640455-2

Connections:
+3V3: C9.1, C26.1, C30.1, C51.1, R7.2, R13.2, R52.1, R63.1, R68.2, R74.1, R79.2, R85.1, U3.P$8 (VDD), U4.P$8 (VDD), U5.P$8 (VDD), U6.P$8 (VDD); also elsewhere on the board
GND: C45.2, C46.2, JP3.1, JP5.1, JP6.1, JP7.1, JP8.1, JP9.1, JP10.1, JP11.1, JP12.1, JP13.1, JP14.1, X7.1, X11.1; also elsewhere on the board
GNDI: C9.2, C26.2, C30.2, C51.2, JP3.2, JP5.2, JP6.2, JP7.2, JP8.2, JP9.2, JP10.2, JP11.2, JP12.2, JP13.2, JP14.2, R8.1, R16.1, R26.2, R50.2, R60.1, R65.1, R69.1, R72.2, R76.1, R80.1, R83.2, R87.1, U3.P$1 (GND), U3.P$3 (GND3), U3.P$5 (GND5), U3.P$6 (GND6), U3.P$7 (GND7), U3.P$9 (GND9), U3.P$10 (GND10), U3.P$13 (GND13), U3.P$17 (GND17), U3.P$18 (GND18), U3.P$21 (PAD), U4.P$1 (GND), U4.P$3 (GND3), U4.P$5 (GND5), U4.P$6 (GND6), U4.P$7 (GND7), U4.P$9 (GND9), U4.P$10 (GND10), U4.P$13 (GND13), U4.P$17 (GND17), U4.P$18 (GND18), U4.P$21 (PAD), U5.P$1 (GND), U5.P$3 (GND3), U5.P$5 (GND5), U5.P$6 (GND6), U5.P$7 (GND7), U5.P$9 (GND9), U5.P$10 (GND10), U5.P$13 (GND13), U5.P$17 (GND17), U5.P$18 (GND18), U5.P$21 (PAD), U6.P$1 (GND), U6.P$3 (GND3), U6.P$5 (GND5), U6.P$6 (GND6), U6.P$7 (GND7), U6.P$9 (GND9), U6.P$10 (GND10), U6.P$13 (GND13), U6.P$17 (GND17), U6.P$18 (GND18), U6.P$21 (PAD)
I2C2_SCL: U3.P$19 (SCL), U4.P$19 (SCL), U5.P$19 (SCL), U6.P$19 (SCL); also elsewhere on the board
I2C2_SDA: U3.P$20 (SDA), U4.P$20 (SDA), U5.P$20 (SDA), U6.P$20 (SDA); also elsewhere on the board
unnamed: R50.1, R51.2
unnamed: L3.1, R52.2, R56.1, R59.2
unnamed: JP15.1, L3.2
unnamed: JP15.2, L1.2
unnamed: JP16.2, L4.2
unnamed: R7.1, R8.2, U3.P$16 (ADDR)
unnamed: R13.1, R16.2, U4.P$16 (ADDR)
unnamed: L5.1, R22.1, R63.2, R64.2
unnamed: C29.2, R22.2, U4.P$2 (VIN+)
unnamed: C29.1, R24.2, U4.P$4 (VIN-)
unnamed: JP16.1, L5.2
unnamed: L4.1, R24.1, R27.1
unnamed: R26.1, R27.2
unnamed: R64.1, R65.2
unnamed: C49.2, R56.2, U3.P$2 (VIN+)
unnamed: C49.1, R58.2, U3.P$4 (VIN-)
unnamed: L1.1, R51.1, R58.1
unnamed: R59.1, R60.2
unnamed: JP17.2, L6.2
unnamed: R68.1, R69.2, U5.P$16 (ADDR)
unnamed: L7.1, R70.1, R74.2, R75.2
unnamed: C50.2, R70.2, U5.P$2 (VIN+)
unnamed: C50.1, R71.2, U5.P$4 (VIN-)
unnamed: JP17.1, L7.2
unnamed: L6.1, R71.1, R73.1
unnamed: R72.1, R73.2
unnamed: R75.1, R76.2
unnamed: JP18.2, L8.2
unnamed: R79.1, R80.2, U6.P$16 (ADDR)
unnamed: L9.1, R81.1, R85.2, R86.2
unnamed: C58.2, R81.2, U6.P$2 (VIN+)
unnamed: C58.1, R82.2, U6.P$4 (VIN-)
unnamed: JP18.1, L9.2
unnamed: L8.1, R82.1, R84.1
unnamed: R83.1, R84.2
unnamed: R86.1, R87.2
unnamed: R18.1, R40.1, X11.2
unnamed: R17.1, R39.1, X7.2
THERM_EXT3: C46.1, R40.2; also elsewhere on the board
THERM_EXT4: C45.1, R39.2; also elsewhere on the board
VDD_ADC: R17.2, R18.2; also elsewhere on the board

Notes on the sheet:
Thermistors
Thermocouples

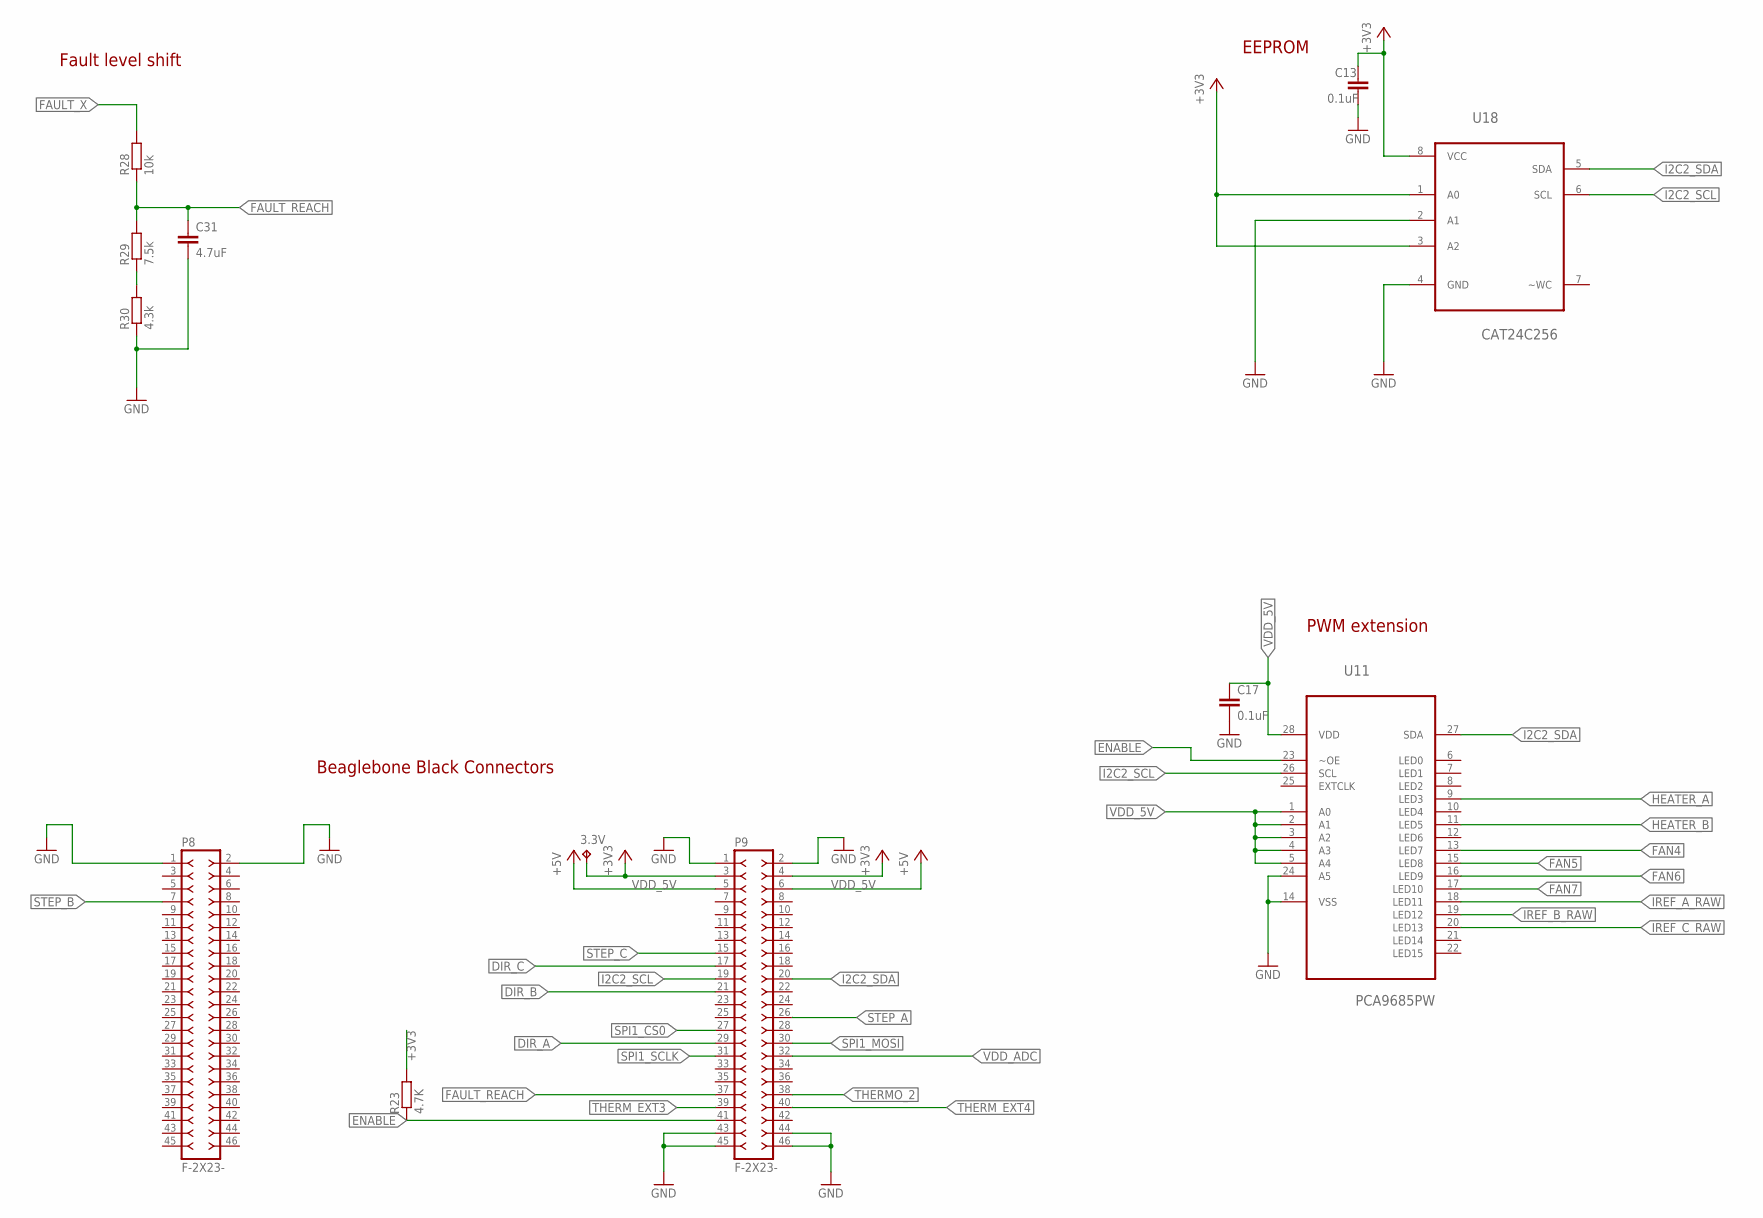
[picture p10: schematic Reach_B0.sch, sheet 5, Connectors]

Parts:
3.3V: TPB1,27; B1,27
C13, C17: 0.1uF; C0402
C31: 4.7uF; C0402
P8, P9: F-2X23-; DIL-100-2X23
R23: 4.7K; R0402
R28: 10k; R0402
R29: 7.5k; R0402
R30: 4.3k; R0402
U11: PCA9685PW; SOP65P640X110-28N
U18: CAT24C256; SOIC127P600X175-8N

Connections:
+3V3: 3.3V.TP, C13.1, P9.3, P9.4, R23.2, U18.1 (A0), U18.3 (A2), U18.8 (VCC); also elsewhere on the board
DIR_A: P9.29; also elsewhere on the board
DIR_B: P9.21; also elsewhere on the board
DIR_C: P9.17; also elsewhere on the board
ENABLE: P9.41, R23.1, U11.23 (~OE)
FAN4: U11.13 (LED7); also elsewhere on the board
FAN5: U11.15 (LED8); also elsewhere on the board
FAN6: U11.16 (LED9); also elsewhere on the board
FAN7: U11.17 (LED10); also elsewhere on the board
FAULT_REACH: C31.1, P9.37, R28.1, R29.2
FAULT_X: R28.2; also elsewhere on the board
GND: C13.2, C17.2, C31.2, P8.1, P8.2, P9.1, P9.2, P9.43, P9.44, P9.45, P9.46, R30.1, U11.14 (VSS), U11.24 (A5), U18.2 (A1), U18.4 (GND); also elsewhere on the board
HEATER_A: U11.9 (LED3); also elsewhere on the board
HEATER_B: U11.11 (LED5); also elsewhere on the board
I2C2_SCL: P9.19, U11.26 (SCL), U18.6 (SCL); also elsewhere on the board
I2C2_SDA: P9.20, U11.27 (SDA), U18.5 (SDA); also elsewhere on the board
IREF_A_RAW: U11.18 (LED11); also elsewhere on the board
IREF_B_RAW: U11.19 (LED12); also elsewhere on the board
IREF_C_RAW: U11.20 (LED13); also elsewhere on the board
unnamed: R29.1, R30.2
SPI1_CS0: P9.27; also elsewhere on the board
SPI1_MOSI: P9.30; also elsewhere on the board
SPI1_SCLK: P9.31; also elsewhere on the board
STEP_A: P9.26; also elsewhere on the board
STEP_B: P8.7; also elsewhere on the board
STEP_C: P9.15; also elsewhere on the board
THERMO_2: P9.38
THERM_EXT3: P9.39; also elsewhere on the board
THERM_EXT4: P9.40; also elsewhere on the board
VDD_5V: C17.1, P9.5, P9.6, U11.1 (A0), U11.2 (A1), U11.3 (A2), U11.4 (A3), U11.5 (A4), U11.28 (VDD)
VDD_ADC: P9.32; also elsewhere on the board

Notes on the sheet:
EEPROM
Fault level shift
Beaglebone Black Connectors
PWM extension

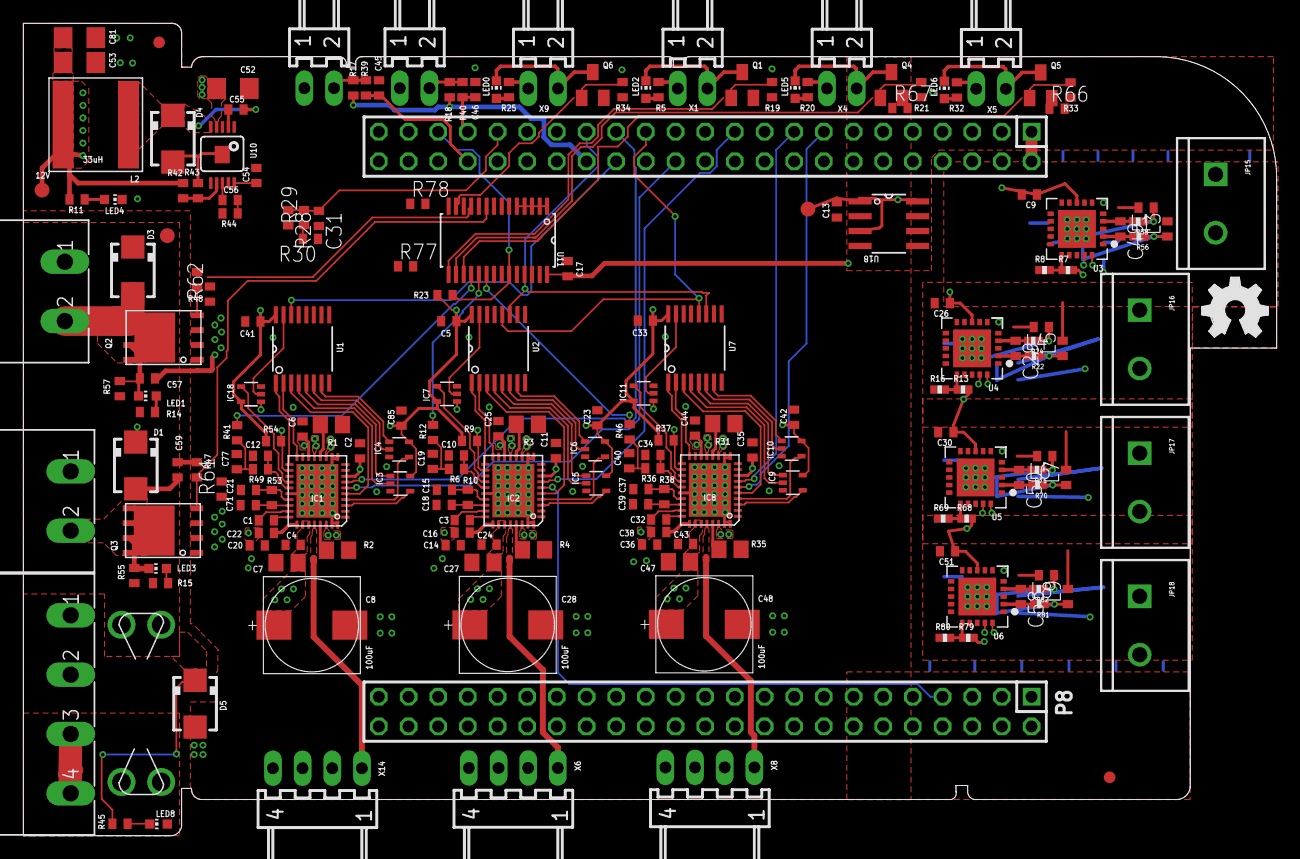
[picture p11: board Reach_B0.brd from above]

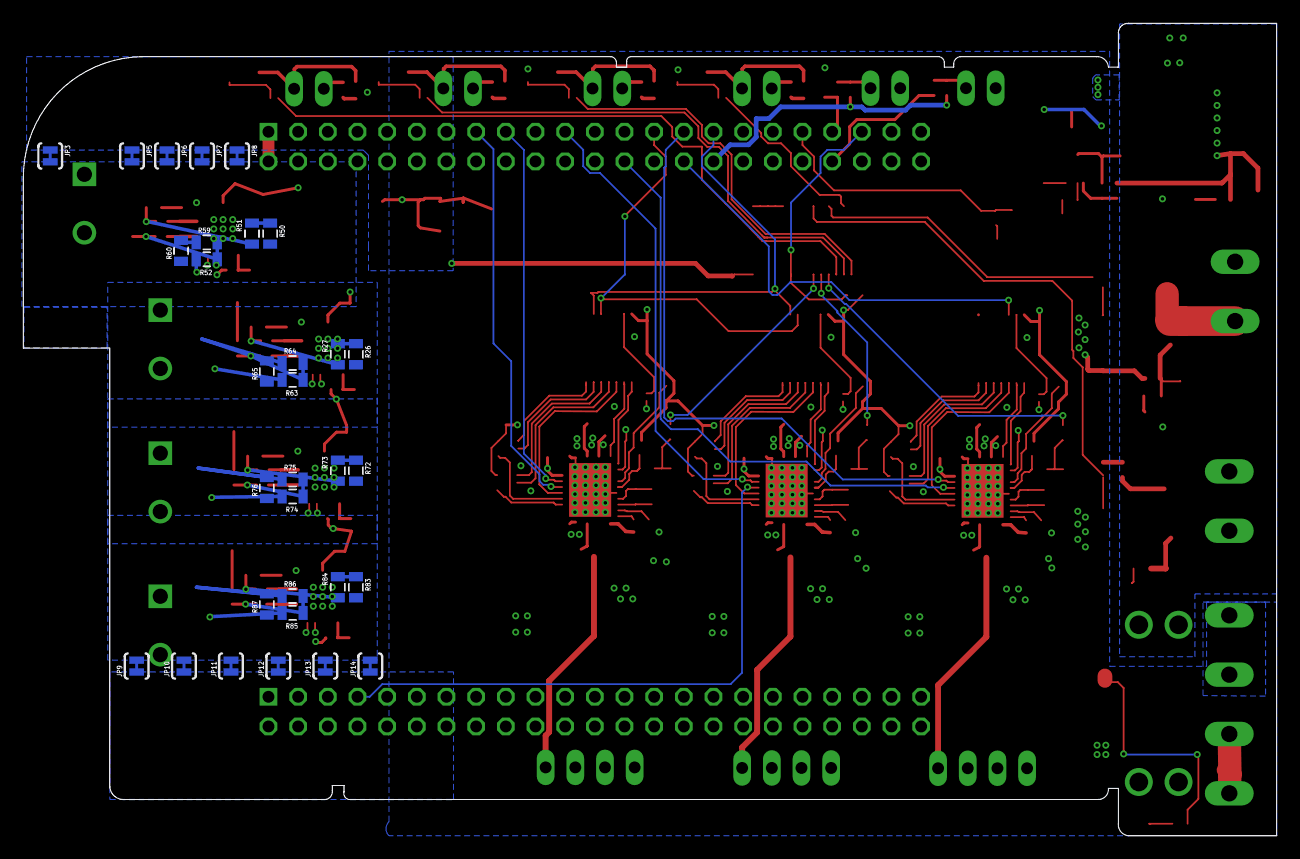
[picture p12: board Reach_B0.brd from below]

Board: 4 copper layers, 107.3 x 69.5 mm, 237 parts (31 on the bottom side), 173 nets.

Other parts of the board:
U$1: LOGO_BIG
