frogfigther/Reach/(commit log)

2017-03-10 added pinout files and a basic BOM
    [Reach_BOM_rev_B0.xls, Reach_Rev_B0_pin-mux.ods]
2017-03-10 reach version B0 for replicape
    Nightly upload of reach board for replicape 3/10/17
    [Reach_B0.brd, Reach_B0.sch]
2017-03-11 I2C address tally
    [i2c_addresses.xls]
2017-03-11 multisheet schematic changes
    [Reach_B0.brd, Reach_B0.sch]
2017-03-12 stepper drivers laid out
    [Reach_B0.brd, Reach_B0.sch]
2017-03-12 example layout of esd and low pass filter added to thermocouple1
    [Reach_B0.brd, Reach_B0.sch]
2017-03-13 supply layout complete
    [Reach_B0.brd, Reach_B0.sch]
2017-03-18 thermocouple layout complete
    [Reach_B0.brd, Reach_B0.sch]
2017-03-19 FETs added
    [Reach_B0.brd, Reach_B0.sch]
2017-03-20 added combined pinout of reach and replicape
    still needs a lot of work
    [REACH AND REPLICAPE_pin-mux.ods]
2017-03-30 reformat of document layout
    [REACH AND REPLICAPE_pin-mux.ods]
2017-04-16 update pin map
2017-05-08 Add files via upload
    Changed pinout to make layout simpler
    [REACH AND REPLICAPE_pin-mux_A.ods, Reach_B0.brd, Reach_B0.sch]
2017-07-30 TMC2130
    Updated to TMC2130 for stepper driver, testing screw terminal layout for thermocouple connections (thermocouple connectors too expensive).
    [Reach_B0.brd, Reach_B0.sch]
2017-11-29 removed LCD jumpers
    [Reach_B0.brd, Reach_B0.sch]
