frogfigther/Reach/(notices)

Notices in the files:
parts and their libraries:
con-headers-jp: Copyright (C) 2008, Bob Starr
SparkFun-Resistors: Licensing: CC v3.0 Share-Alike You are welcome to use this library for commercial purposes.
SparkFun-PassivesNEW: Licensing: Creative Commons ShareAlike 4.0 International - https://creativecommons.org/licenses/by-sa/4.0
